qq45119626FangZhi/Temperature-Controlled-Blender/TempStir/MDK-ARM/Doc/使用文档.md

# TempStir 智能温控搅拌机 · 使用文档

> 适用固件：**v1.1**（Modbus 寄存器 `0x000F` = `0x0101`）
> 目标板：STM32F103RCT6 / STM32Cube HAL / FreeRTOS
> 工程：`MDK-ARM/TempStirV1.0.uvprojx`（Keil MDK V5.38 / ARMCC V5）
> 本文覆盖：**安装接线 → 上电 → 面板操作 → 控温/搅拌规则 → 通信 → 保护与故障码 → 烧录调试 → 出厂自检 → 老化测试 → 已知限制**

---

## 1. 产品概述

智能温控搅拌机：铝板加热 + 搅拌电机，双路 NTC 测温（液体 / 铝板），OLED 面板设定，支持 RS485/Modbus 与 BLE 蓝牙两路上位机，参数掉电保存，RTC 走时。

### 1.1 功能清单

| 功能 | 说明 | 状态 |
|---|---|---|
| 双路测温 | 液体 NTC（PB1）+ 铝板 NTC（PB0），Steinhart-Hart 换算 + 8 点滑动平均 + 断线/短路判定 | ✅ |
| 加热控温 | 液体目标温度 PID 闭环，PWM 20 kHz（TIM2_CH1 / PA0） | ✅ |
| 铝板限温 | 板温 ≥ 上限锁存断电，降到「上限 − 2.0℃」解除；`0` = 不限制 | ✅ |
| 搅拌调速 | 编码器测速 + 转速 PID 闭环，PWM 20 kHz（TIM4_CH3 / PB8） | ✅ |
| 堵转保护 | 占空比大但转速起不来，持续 3 s → 停机 + 故障位 bit5 | ✅ |
| 风扇自动 | 板温 ≥35℃ 开 / ≤32℃ 关，最短切换间隔 5 s | ✅ |
| 蜂鸣提示 | 短鸣 / 长鸣（4 kHz 无源，TIM1_CH1 / PA8） | ✅ |
| 面板 UI | 0.96" OLED 128×64 + 4 按键，6 行「设定/实测」 | ✅ |
| 定时 | 0~999 s，电机启动开始倒计时，归零自动停机 | ✅ |
| 参数存储 | M24C02 EEPROM，双槽 + CRC16 + 版本迁移（v4） | ✅ |
| RTC | DS3231 走时 + 1 Hz SQW 秒节拍，面板/串口校时 | ✅ |
| RS485 / Modbus RTU | UART4，9600 8N1，从机 1，32 个保持寄存器（03/06/10） | ✅ |
| BLE 蓝牙 | USART2 + ECB01C 透传，同一套 Modbus 帧 | ✅ |
| 故障监控 / 看门狗 | 故障字聚合、三源心跳、IWDG ≈1.6 s、上电打印复位原因 | ✅ |
| CAN | 本期未实现 | ⛔ |

---

## 2. 硬件接口

### 2.1 引脚与信号

| 功能 | 网络 | 引脚 | 说明 |
|---|---|---|---|
| 铝板 NTC | BOARD_ADC | PB0 / ADC1_IN8 | 10k 分压，室温 25℃ 原始值约 **2047** |
| 液体 NTC | LIQUID_ADC | PB1 / ADC1_IN9 | 同上 |
| 加热电流 | HEAT_I_ADC | PA4 / ADC1_IN4 | INA199 放大，R29 5 mΩ 采样 |
| 24 V 电压 | SUPPLY_24V_ADC | PC0 / ADC1_IN10 | 电源电压检测 |
| 加热 PWM | HEAT_PWM | PA0 / TIM2_CH1 | **20 kHz**，占空比 0~100% |
| 风扇 | MOTOR_ON | PA1 | **高有效** |
| 电机 PWM | MOTOR1 | PB8 / TIM4_CH3 | **20 kHz**；PB9（MOTOR2）**必须固定低**（拉高会反转/刹车） |
| 编码器 | M1_ENC_A/B | PB4 / PB5 / TIM3 | 正交编码器接口 |
| 蜂鸣器 | BUZZ | PA8 / TIM1_CH1 | 4 kHz 无源，50% 占空比驱动 |
| 按键 | KEY1~KEY4 | PC6 / PC7 / PC8 / PC9 | 内部上拉，按下接地（低有效） |
| OLED | — | PB6 / PB7（I2C1） | SSD1315，地址 0x3C 类 |
| EEPROM | — | PB10 / PB11（I2C2） | M24C02 |
| RTC | — | PB10 / PB11（I2C2） | DS3231；SQW → PC12（DS_INT） |
| 加热故障锁存 | HEAT_FAULT_N | PC3 | **低有效**（74LVC1G74 锁存），复位脚 FAULT_RST_N = PC2 |
| 调试串口 | — | PA9 / PA10（USART1） | **115200 8N1**，printf 重定向 |
| RS485 | — | PC10 / PC11（UART4） | MAX13487E 自动方向 |
| 蓝牙 | — | PA2 / PA3（USART2） | ECB01C，9600 8N1 |
| 调试口 | SWD | PA13 / PA14 | CMSIS-DAP |

### 2.2 上电顺序建议

1. 接好 24 V 加热电源与 MCU 电源（**加热组件禁止空载长时间通电**）；
2. 接好调试器（CMSIS-DAP）或 USB-串口（看日志）；
3. 上电 → OLED 显示 `TempStir V1.0`，串口打印启动信息（见 3.2）。

---

## 3. 上电与日志

### 3.1 上电默认状态

| 项 | 上电值 |
|---|---|
| 电机 | **停止**（必须人为启动） |
| 加热 | 关闭（需设定液体目标 + 启动电机） |
| 速度 / 液体目标 / 定时 | 从 EEPROM 恢复（默认 0 / 0 / 0） |
| 铝板上限 | 从 EEPROM 恢复（默认 **40℃**；旧固件的 1~34℃ 非法值会自愈为 40℃） |
| 通信 | RS485 + 蓝牙都开，9600 8N1，从机地址 1 |
| 蜂鸣器 | 静音 |

### 3.2 启动日志（USART1，115200）

```
[P7] reset cause: IWDG=0 WWDG=0 SW=0 POR=1 PIN=1 LPWR=0
[P7] fault monitor init
[P5] EEPROM=OK
[P5] DS3231=OK 2026-11-05 11:23:41 valid=1 sqw=1
[P5] PARAM speed=0 plate=40 liquid=0 time=0
[P5] CALIB mPID=2000/500/0 hPID=2000/50/0 PPR=44 gearX100=3000
[P5] STAT boot=85 run=2350 s heat=5211 s start=37
[P6] BLE baud=9600 (AT ok)
[P6] BLE name=BT_ECB1A6B01BA2 link=disconnected baud=9600
[P7] IWDG on (timeout ~1600 ms)
```

关键判读：

- `reset cause: IWDG=1` → 上次是**看门狗复位**（任务卡死/异常），不是正常上电；
- `EEPROM=NG` → 参数无法保存（检查 I2C2 / 芯片）；`DS3231=NG` → 时间不可用；
- `RTC time lost (OSF=1)` → 纽扣电池没电/未装，已用编译时刻兜底；
- `BLE ... link=disconnected` → 蓝牙在线但未连接手机，属正常。

---

## 4. 面板操作

### 4.1 按键

| 按键 | 短按 | 长按（≥600 ms） |
|---|---|---|
| **KEY1**（PC6） | 切换焦点：速度 → 铝板 → 液体 → 时间 → 循环 | 进入/退出 **RTC 校时页** |
| **KEY2**（PC7） | 当前项 **+1 步** | 600 ms 后每 80 ms 连发 |
| **KEY3**（PC8） | 当前项 **−1 步** | 600 ms 后每 80 ms **连发减值**（原「长按进六轴页」已停用，见 5.6） |
| **KEY4**（PC9） | **启动 / 停止电机**（启动即开始倒计时） | 进入 / 退出 **标定页**（见 4.5） |

> 焦点行前有 `>` 箭头。面板任意按键后 **8 s 内**通信写命令会被拒绝（返回异常码 06，防抢控）。
>
> **KEY4 为"松手生效"**：按下不动作，松开瞬间才执行启动/暂停（校时页=写入并退出、标定页=保存并退出）。长按 ≥600 ms 只切换页面，**不会改变电机启停状态**。KEY1/KEY2/KEY3 仍是"按下即触发"。

### 4.2 主界面（6 行，"设定/实测"）

```
TempStir V1.0
>Speed  100/80 rpm      设定转速 / 编码器实测转速（电机轴 RPM）
 Plate   60/25 C        铝板上限温度 / 铝板实测温度
 Liquid  45/23 C        液体目标温度 / 液体实测温度
 Time   60/45 s         设定时间 / 剩余时间（秒）
 Motor  Running         运行状态：Running / Idle
```

- 实测温度显示 `--` 表示 NTC 采样失败（断线/短路）；
- 无按键时每 480 ms 刷新一次；RTC 1 Hz 秒节拍到来时立即刷新。

### 4.3 参数范围

| 项 | 范围 | 步长 | 说明 |
|---|---|---|---|
| Speed | 0 ~ 500 rpm | 5 | 电机轴 RPM，与编码器同量纲 |
| Plate | 0 ~ 120 ℃ | 1 | **上限（保护门限）**；`0`=不限制；有效域 `{0} ∪ [35,120]`，1~34 会被当作 0 |
| Liquid | 0 ~ 100 ℃ | 1 | **加热目标**；`0` = 不加热 |
| Time | 0 ~ 999 s | 1 | `0` = 不限时 |

### 4.4 RTC 校时（长按 KEY1）

```
Set RTC
Date 2026-11-05
Time 11:23:41
K1  next field
K2+ K3-  K4 save
Motor  Idle
```

- KEY1 循环切换 **年 / 月 / 日 / 时 / 分 / 秒**；
- KEY2/KEY3 增减（年 2000~2099、月 1~12、日按当月天数、时分秒 24/60 循环）；
- KEY4 **松开时**写入 RTC 并退出；星期自动推算。

### 4.5 标定页（长按 KEY4 进入，KEY4 保存并退出）

出厂/维修标定用，**只改标定参数，不动速度与温度目标，也不改变电机/加热状态**。

```
CALIB 3/8
NTC R25 ohm
10000 ohm
K1 next  K2+ K3-
K4 save+exit
Motor  Idle
```

| 序号 | 项目 | 含义 | 范围 / 步长 |
|---|---|---|---|
| 1 | Encoder PPR | 编码器每转计数（线数×4） | 4~4096，步 4 |
| 2 | Gear x100 | 减速比×100（例 `3000` = 30.00） | 100~10000，步 100 |
| 3 | NTC R25 ohm | NTC 25℃ 阻值 | 1000~100000Ω，步 500 |
| 4 | NTC B (K) | NTC B 常量 | 1000~6000K，步 50 |
| 5 | NTC Rup ohm | 分压上拉电阻 | 500~100000Ω，步 500 |
| 6 | Heat OC raw | 加热过流判定阈值（ADC 原始值） | 500~4000，步 50 |
| 7 | Liquid off | 液体温度校准偏移 | −100~100（0.1℃），步 1 |
| 8 | Board off | 铝板温度校准偏移 | −100~100（0.1℃），步 1 |

- KEY1 切换项目（循环），KEY2/KEY3 增减（长按连发），**KEY4 短按松开即保存并退出**（写 EEPROM + 立即生效，无需重启）；
- 长按 KEY4（≥600 ms）只进出标定页，**不保存**；按住期间不会误改电机启停；
- 标定时建议电机停止，改完 NTC 参数后观察主界面实测温度与实际温度是否一致，再用偏移微调；
- 保存时串口打印 `[P8] CALIB saved: ppr=… gearX100=… R25=… B=… Rup=… OC=… offL=… offB=…`。

---

## 5. 控制逻辑与安全行为

### 5.1 温度语义（**重要**）

| 项 | 含义 |
|---|---|
| 面板 **Liquid** | **加热目标温度**（唯一 PID 设定值）。=0 时不加热。 |
| 面板 **Plate** | **铝板上限温度 + 铝板实测值**。上限只做保护，**不是加热目标**。 |

> 想加热：设 `Liquid`（如 30~45℃），并**启动电机**；`Plate` 保持 40℃ 作为板温上限即可。

### 5.2 加热启动条件（全部满足才加热）

1. 无加热类故障（HEAT_FAULT_N / 过流 / NTC 异常 / 铝板限温锁存）；
2. **电机运行中**（目标转速 ≠ 0 且未堵转）；
3. 液体目标温度 > 0；
4. 液体温度低于目标（或 PID 输出 > 0）。

### 5.3 加热停止条件

| 触发 | 行为 | 恢复 |
|---|---|---|
| 液体到目标（曾低于目标后首次达到） | 关加热**锁存** + 蜂鸣长鸣 1 s + 状态字 bit9 | 改液体目标 / 重新启停电机 / `0x0007` 清故障 |
| 铝板 ≥ 上限 | 关加热锁存 + 故障位 bit4 | 板温降到「上限 − 2℃」以下，或改上限，或清故障 |
| 板温 NTC 无效 | 立即关加热（fail-safe）+ 故障位 bit3 | NTC 恢复正常见后自动恢复 |
| 电机停机 / 堵转 | 撤销加热许可 | 重新启动电机 |
| 加热硬件故障 / 过流 | 立即关加热 + 故障位 bit0/bit1 | 排除硬件后清故障（`0x0007` bit2） |

### 5.4 其它自动行为

- **风扇**：板温 ≥35.0℃ 开、≤32.0℃ 关，两次切换至少间隔 5 s；
- **液温上穿 30.0℃**：蜂鸣长鸣 1 s（边沿触发，**下降不响**；默认不停电机，宏 `APP_TEMP_MARK_STOP_MOTOR` 可改为同时停机）；
- **定时**：KEY4 启动即开始倒计时，归零自动停机并落盘统计；
- **统计**：累计运行时间 / 加热时间 / 启动次数，每 5 分钟或停机时写 EEPROM。

### 5.5 保护一览

| 保护 | 阈值 / 判据 | 动作 |
|---|---|---|
| 加热硬件故障 | HEAT_FAULT_N 低 | 关加热，故障位 bit0 |
| 加热过流 | 电流 ADC raw > 3500（**待整定**） | 关加热，故障位 bit1 |
| 液体 / 铝板 NTC 断线短路 | raw < 100 或 > 4000 | 关加热（液体 NTC 异常也禁止加热） |
| 铝板限温 | 板温 ≥ 上限（回差 2.0℃） | 关加热锁存，故障位 bit4 |
| 电机堵转 | 目标>0 且占空比≥40% 且 RPM<目标×25% 且 <10，连续 3 s | 停机锁存，故障位 bit5 |
| 任务卡死 | 任一关键任务心跳丢失 >500 ms | WDG 停喂，IWDG 约 1.6 s 复位 |
| EEPROM / RTC 异常 | 探测失败 / OSF=1 | 故障位 bit6 / bit7（不禁止加热/电机） |
| 倾斜保护（P9） | max(\|roll\|,\|pitch\|) > 门限（默认 10.0°，0x0036）持续 500 ms，回差 3.0° 且持续 500 ms 解除 | 电机运转中立即停机 + 蜂鸣器长鸣；状态位 0x002A bit8 = 倾斜锁存 |
| 打滑告警（P9/M4） | 陀螺推算转速与编码器偏差 > 门限（默认 15.0%，0x0034）持续 1 s | **当前默认关闭**（IMU 固定底座，见 5.6）；仅在 `APP_IMU_SLIP_ENABLE=1` 时生效：仅告警不停机 |
| 升温异常（A3） | 目标液温>0、占空比 ≥50%、电机运行中，120 s 内液温上升 <2.0℃ | **仅告警**：状态字 bit12 + 蜂鸣 1.5 s + 串口 `[P11] liquid no-rise`（不停机、不关加热） |
| 板温不升（P10，默认关） | 板温目标模式下占空比 ≥50% 且板温 raw 30 s 不动 | 关加热锁存（该模式默认关闭） |
| 堵转辅助（M5，默认关） | 0x003B bit0=1 且 IMU 检测到振动（振动 RMS > 0x0035） | 堵转判定时间 3 s → 1 s |

### 5.6 六轴（LSM6DSM）相关行为

- 采集：SPI2 100 Hz（CS=PB12），上电 2 s 自动零偏标定并落盘；未贴件/通信失败时所有判据自动降级，**电机/加热/通信不受影响**（故障位 bit8 提示）；
- 倾斜保护：见 5.5。倾角超限会**停机**，因此“倾斜锁存期间 App/面板再按启动会被再次停掉”属预期行为；
- 打滑（M4）：**默认关闭**。本机 IMU 固定在底座、不随搅拌轴转动，陀螺测不到转速（ω_imu 恒 0），偏差恒为 100.0%，会误报 bit7/状态字 bit11，故 `APP_IMU_SLIP_ENABLE=0`；判据代码保留，将来若 IMU 改为随轴装配再置 1。关闭后 `0x002F` 恒 0；
- 参数（打滑/振动/倾斜/斜率/过流）可现场改：面板标定页覆盖 PPR/减速比/NTC/过流/温度偏移，**六轴门限用 App「六轴门限 / 参数设置」或网页版参数区**（写 0x0033~0x0036、0x003A），即时生效并掉电保存；
- **面板六轴显示页（原第 7 页，长按 KEY3 进出）已停用**：该页占用 KEY3 长按，导致长按无法连发减值，故 `menu_ui.c` 的 `MENU_UI_IMU_PAGE_ENABLE=0`，入口不调用、KEY3 长按归还连发；页面代码完整保留，改宏为 `1` 重烧即恢复（届时 KEY3 长按会被页面占用）。六轴数据仍可通过 0x0020~0x0032 读取（App/网页版）；
- 可选扩展（默认全关，需改宏重烧并实机复验）：`APP_IMU_SELFTEST_ENABLE`（上电 CTRL5_C 自检）、`APP_IMU_FIFO_ENABLE`（FIFO 批量采样）、`APP_MOTOR_STALL_ASSIST_DEFAULT`（运行期默认开辅助堵转）。

---

## 6. 通信

### 6.1 RS485 / Modbus RTU（**当前版本不支持**）

> ⚠️ **本版本不使用 RS485 通道**：主站实测所需的 USB-485 转换器未到位，且该通道不在本版出厂功能范围内。
> 代码保留（UART4 + MAX13487E），但**不要按 RS485 交付**；下表的寄存器/帧格式仍然有效，**通过蓝牙访问**。

- 参数（蓝牙链路）：**9600 8N1，从机地址 1**；
- 功能码：`03` 读保持寄存器、`06` 写单个、`10` 写多个；
- 异常码：`02` 非法地址、`04` 数值非法/保护联锁、`06` 从机忙（面板 8 s 占用）。

### 6.2 保持寄存器表（**64 个，0x0000~0x003F**；v1.2 起扩表，旧上位机只读前 32 个不受影响）

| 地址 | 名称 | 类型/单位 | 读写 | 说明 |
|---|---|---|---|---|
| 0x0000 | 当前液温 | int16 / 0.1℃ | R | |
| 0x0001 | 目标液温 | int16 / 0.1℃ | R/W | 0~1000（0~100.0℃），即加热目标 |
| 0x0002 | 当前转速 | int16 / rpm | R | 编码器实测（电机轴） |
| 0x0003 | 目标转速 | int16 / rpm | R/W | 0~500 |
| 0x0004 | 剩余时间 | uint16 / s | R | |
| 0x0005 | 系统状态字 | 位域 | R | 见 6.4 |
| 0x0006 | 故障码 | 位域 | R | 见 6.5 |
| 0x0007 | 控制命令 | 位域 | R/W | 见 6.6（写入后自动执行） |
| 0x0008 | 铝板温度 | int16 / 0.1℃ | R | 实测 |
| 0x0009 | 加热占空比 | uint16 / % | R | |
| 0x000A | 电机占空比 | uint16 / % | R | |
| 0x000B | 设定时间 | uint16 / s | R/W | 0~999 |
| 0x000C | 风扇状态 | 0/1 | R | |
| 0x000D/0x000E | 设备 ID | 32 位 | R | 由 UID 派生 |
| 0x000F | 固件版本 | 高字节主/低字节次 | R | v1.1 = 0x0101 |
| 0x0010 | 从机地址 | 1~247 | R/W | 重启生效（本版 RS485 不对外支持） |
| 0x0011 | 波特率代码 | 0~4 | R/W | 0=9600 1=19200 2=38400 3=57600 4=115200，重启生效 |
| 0x0012/0x0013 | 累计运行时间 | 32 位 / s | R | |
| 0x0014 | 面板焦点项 | 0~3 | R/W | 0=速度 1=铝板 2=液温 3=时间（OLED 箭头随动） |
| 0x0015 | 铝板上限温度 | 整数 ℃ | R/W | `0` 或 `35~120`；写 1~34 返回异常码 04 |
| 0x0018~0x001D | PID 参数镜像 | ×1000 定点 | R | 只读预留 |

#### 6.2.1 六轴 / 姿态 / 斜坡 / 打滑区块（0x0020~0x0039，v1.2 起）

| 地址 | 名称 | 类型/单位 | 读写 | 说明 |
|---|---|---|---|---|
| 0x0020~0x0022 | 加速度 X/Y/Z | int16 / mg | R | 静止时 Z ≈ +1000 |
| 0x0023~0x0025 | 角速度 X/Y/Z | int16 / 0.1dps | R | 已扣上电零偏 |
| 0x0026/0x0027 | 横滚 / 俯仰 | int16 / 0.1° | R | 加速度解算 |
| 0x0028 | 相对偏航 | int16 / 0.1° | R | 陀螺积分，会漂移 |
| 0x0029 | 片内温度 | int16 / 0.1℃ | R | |
| 0x002A | IMU 状态位 | 位域 | R | 0x0001 有效 / 0x0002 静止 / 0x0004 转动 / 0x0008 振动 / 0x0010 倾斜 / 0x0040 已标定 / 0x0080 打滑 / 0x0100 倾斜锁存 |
| 0x002B | 振动 RMS | uint16 / mg | R | 1 s 窗 |
| 0x002C | 角加速度 | int16 / 0.1dps/s | R | 旋转轴，低通后 |
| 0x002D | 斜坡状态 | 0~3 | R | 0 停 / 1 加速 / 2 匀速 / 3 减速 |
| 0x002E | 斜坡指令转速 | int16 / rpm | R | PID 跟随的中间量 |
| 0x002F | 打滑偏差 | int16 / 0.1% | R | 陀螺推算转速与编码器偏差 |
| 0x0030 | IMU 控制字 | 位域 | R/W | bit1 零偏标定 / bit2 保存参数 / bit3 清事件（写后读回恒 0） |
| 0x0031/0x0032 | 加速度 / 陀螺配置 | 低字节量程 高字节 ODR | R/W | 重启生效（0~3 / 0~9） |
| 0x0033 | 加减速斜率 | uint16 / rpm/s | R/W | 默认 600 |
| 0x0034 | 打滑门限 | uint16 / 0.1% | R/W | 默认 150 = 15.0%；**打滑判据当前默认关闭**（IMU 固定底座），地址与门限保留 |
| 0x0035 | 振动门限 | uint16 / mg | R/W | 默认 300 |
| 0x0036 | 倾斜门限 | uint16 / 0.1° | R/W | 默认 100 = 10.0° |
| 0x0037/0x0038 | 加速 / 减速耗时 | uint16 / ms | R | 上次实测（口径=目标变更→到达，含首拍；600 rpm/s 爬 200 rpm ≈ 400 ms） |
| 0x0039 | 峰值角加速度 | int16 / 0.1dps/s | R | 本次启动以来 |

#### 6.2.2 v1.3 新增：现场可调参数与实测统计（0x003A~0x003C）

| 地址 | 名称 | 类型/单位 | 读写 | 说明 |
|---|---|---|---|---|
| 0x003A | 加热过流阈值 | uint16 / ADC raw | R/W | 合法 100~4095，掉电保存；与面板标定页同一份数据 |
| 0x003B | 堵转辅助位域 | 位域 | R/W | bit0 = 1 启用振动辅助堵转（3 s→1 s），默认 0（掉电保存） |
| 0x003C | 实测统计控制 | 位域 | R/W | bit0 周期打印 `[TUNE]`（每 5 s）/ bit1 立即打印一行 / bit2 清统计；**不落盘**，复位后为 0 |
| 0x003D~0x003F | 保留 | — | R | 读 0 |

> 现场整定流程（A2）：写 `0x003C = 0x0003`（开打印 + 立即打一行）→ 串口每 5 s 出现一行 `[TUNE]`，含
> `slip=实测/门限`、`vib=实测/门限`、`acc/dec ms`、`gyroZ/biasZ`（零偏温漂）、`novRise`、`assist`，
> 据此改 0x0033~0x0036 / 0x003A 后即时生效并保存；整定完写 `0x003C = 0` 恢复静默。

### 6.3 读写示例（从机 1）

- 读 0x0000~0x0006（7 个寄存器）：
  `01 03 00 00 00 07 CRC_L CRC_H`
- 写目标液温 = 35.0℃（0x015E = 350）：
  `01 06 00 01 01 5E CRC_L CRC_H`
- 启动电机：`01 06 00 07 00 01 +CRC`；停止：`… 00 02 …`；清故障：`… 00 04 …`

### 6.4 系统状态字（0x0005）

| 位 | 掩码 | 含义 |
|---|---|---|
| bit0 | 0x0001 | 电机运行中 |
| bit1 | 0x0002 | 加热输出中 |
| bit2 | 0x0004 | 风扇运行中 |
| bit3 | 0x0008 | 故障态（故障字 ≠ 0） |
| bit4 | 0x0010 | 定时计时中 |
| bit5 | 0x0020 | RTC 有效 |
| bit6 | 0x0040 | 面板刚被操作（8 s 内） |
| bit8 | 0x0100 | 蓝牙已连接 |
| bit9 | 0x0200 | 液温已达目标，加热结束（锁存） |
| bit10 | 0x0400 | P9：六轴数据有效 |
| bit11 | 0x0800 | P9：打滑告警（陀螺×编码器偏差） |
| bit12 | 0x1000 | **A3：液体升温异常告警**（仅告警，不属于故障字，不停机也不关加热） |

### 6.5 故障码（0x0006）

| 位 | 掩码 | 含义 | 处置 |
|---|---|---|---|
| bit0 | 0x0001 | 加热硬件故障锁存 | 查 HEAT_FAULT_N 回路，排除后清故障 |
| bit1 | 0x0002 | 加热过流 | 查加热组件/短路，阈值待整定 |
| bit2 | 0x0004 | 液体 NTC 异常 | 查接插件/线束 |
| bit3 | 0x0008 | 铝板 NTC 异常 | 查接插件/线束（此位会禁止加热） |
| bit4 | 0x0010 | 铝板限温触发 | 降温或改上限 |
| bit5 | 0x0020 | 电机堵转 | 排除机械卡阻后 KEY4 停机重启或清故障 |
| bit6 | 0x0040 | EEPROM 异常 | 查 I2C2 / M24C02 |
| bit7 | 0x0080 | RTC 掉电丢时 | 换纽扣电池并重新校时 |
| bit8 | 0x0100 | P9：IMU 通信/自检异常 | 查 SPI2（PB12~PB15）/ 是否贴件；不影响其它功能 |

> 注意：液体升温异常（A3）**不进故障字**，只体现在状态字 bit12，避免被“加热类故障”掩码连带触发紧急关加热。

### 6.6 控制命令（0x0007）

| 位 | 掩码 | 动作 |
|---|---|---|
| bit0 | 0x0001 | 启动电机（堵转故障未清时返回 04） |
| bit1 | 0x0002 | 停止电机 |
| bit2 | 0x0004 | 清故障（硬件故障锁存 + 铝板限温锁存 + 堵转锁存） |
| bit3 | 0x0008 | 立即保存参数到 EEPROM |
| bit4 | 0x0010 | 恢复默认参数 |

### 6.7 BLE 蓝牙

- 模块：ECB01CV2-SOP8，出厂名 **`BT_ECB1A6B01BA2`**（名字由 MAC 派生，**不支持自定义名**）；
- 连接方式：**必须用 BLE 工具（如 nRF Connect）连 GATT**，手机系统"配对"会提示失败，属正常；
- 服务 / 特征：`FFF0`（服务）、`FFF1`（Notify，**需在手机侧手动订阅**）、`FFF2`（Write）；
- MTU 未协商（=23）时单包 ≤20 字节，**一次读 ≤7 个寄存器**；MTU 247 可整表读；
- 帧格式与 RS485 完全相同（Modbus RTU + CRC16，主站侧需自行组帧）。

### 6.8 上位机

| 上位机 | 位置 / 方式 |
|---|---|
| 安卓 App「TempStir 蓝牙控制台」 | BLE GATT 直连，功能等同面板 |
| 网页版 | `Doc/web/tempstir_rs485.html`，Chrome/Edge 的 **Web Serial** → USB-485 → 板载 485A/485B。1 s 轮询 0x0000~0x0015，**并追加读 0x0020~0x003F**（六轴/参数区，旧固件自动停读），参数区可写入打滑/振动/倾斜/斜率/过流并开关「辅助堵转 / 统计打印」。**⛔ 本版不支持 RS485，此上位机暂不可用**（文件保留备查） |

> 注意：CherryUSB CMSIS-DAP 的虚拟串口（COM5）**不是** 485 通道，网页版必须选 USB-485 转换器的串口。

---

## 7. 参数存储与 RTC

- **EEPROM（M24C02，v5）**：UI 参数、PID 增益（×1000）、校准系数（PPR/减速比/温度偏移）、**NTC 曲线参数（R25/B/上拉）与加热过流阈值**、通信参数、运行统计；双槽 + CRC16 + 版本迁移（v4 及更早数据上电自动迁移，新字段补默认值）；
- 写入策略：参数改动**静置 2 s** 落盘（防按键连发磨损），统计每 5 分钟或停机落盘；
- **v4 → v5 迁移已实测通过**：升级后启动日志出现 `[P8] NTC R25=10000 B=3950 Rup=10000 | heatOC=3500 | offL=0 offB=0`，且 `[P5] STAT boot=` 连续递增（85 → 90），说明旧参数与统计被沿用、未退回默认值；
- **RTC（DS3231）**：OSF=1 时用编译时刻兜底并打印提示；1 Hz SQW 经 PC12 通知 UI 刷新。

---

## 8. 烧录与调试

```powershell
# 编译
Start-Process "D:\Program Files\Keil_MDK\UV4\UV4.exe" -ArgumentList '-b','TempStirV1.0.uvprojx' -Wait
# 全量重建
Start-Process "D:\Program Files\Keil_MDK\UV4\UV4.exe" -ArgumentList '-r','TempStirV1.0.uvprojx' -Wait
# 烧录（CMSIS-DAP）
Start-Process "D:\Program Files\Keil_MDK\UV4\UV4.exe" -ArgumentList '-f','TempStirV1.0.uvprojx' -Wait
```

- 调试器：CMSIS-DAP（CherryUSB），Flash 算法 `STM32F10x_512.FLM`；
- 若首次烧录报 `Target DLL has been cancelled`，**再执行一次即可**（探针会话偶发未建立）；
- 单步调试时 IWDG 已用 `DBGMCU_CR` 冻结，不会被看门狗打断；
- 当前构建：`Code=63088 RO=2412 RW=712 ZI=20624`，`0 Error(s), 0 Warning(s)`。

---

## 9. 出厂自检 / 整机联调清单

> 每台整机出厂前按下表逐项执行，全部 ✅ 才算通过。`[软件已核对]` 表示代码与构建层面已验证，仍需实机复核。

| # | 项目 | 操作 | 预期 | 状态 |
|---|---|---|---|---|
| 1 | 上电启动 | 上电 | OLED 显示 `TempStir V1.0`；串口打印 `[P7] reset cause` / `[P5] EEPROM=OK` / `DS3231=OK` | [软件已核对] |
| 2 | 显示刷新 | 静置观察 | 每 ~0.5 s 刷新，"实测"温度随环境变化 | [软件已核对] |
| 3 | 按键消抖 | 逐个短按 KEY1~KEY4 | 无连跳/漏按；`>` 箭头循环移动；KEY4 在**松手**时启停 | [软件已核对] |
| 4 | 参数增减 | 焦点在 Speed/Plate/Liquid/Time 时按 KEY2/KEY3 | 按步长增减，长按连发（KEY3 长按=连发减值，不再切六轴页），范围受限 | [软件已核对] |
| 5 | 铝板上限自愈 | 把 Plate 调到 30 | 自动变为 0（不限制）或 40，不锁死加热 | [软件已核对] |
| 6 | RTC 校时 | 长按 KEY1 → 改日期时间 → KEY4 | 校时成功并退出；重上电时间继续走 | ✅ 已实测 |
| 7 | 电机启动 | 设 Speed=100 → KEY4 | 电机转，`Motor Running`，实测 RPM 上升并稳定在 ±5% | ✅ 已实测 |
| 8 | 软启动/停机 | KEY4 停止 | 占空比按 5%/周期下降，无冲击 | ✅ 已实测 |
| 9 | 定时停机 | 设 Time=10 → KEY4 | 剩余时间倒数，归零自动停机 | ✅ 已实测 |
| 10 | 加热启动 | 设 Liquid=35、Plate=40 → KEY4 | 加热占空比 >0，液体温度上升 | ✅ 已实测 |
| 11 | 到温完成 | 液温升到目标 | 关加热、长鸣 1 s、状态字 bit9 | ✅ 已实测 |
| 12 | 铝板限温 | 把 Plate 设为略高于当前板温 | 板温到上限后加热断电，故障位 bit4 | ✅ 已实测 |
| 13 | 30℃ 提示音 | 液温由 <30 升到 ≥30 | 长鸣 1 s；降到 30 以下不再响 | ✅ 已实测 |
| 14 | 风扇 | 板温 ≥35℃ | 风扇开；≤32℃ 关；两次切换 ≥5 s | ✅ 已实测 |
| 15 | 液体 NTC 断线 | 拔液体 NTC | 显示 `--`，故障位 bit2，加热断开 | ✅ 已实测 |
| 16 | 铝板 NTC 断线 | 拔铝板 NTC | 显示 `--`，故障位 bit3，加热断开 | ✅ 已实测 |
| 17 | 加热硬件故障 | 拉低 HEAT_FAULT_N | 加热断电、故障位 bit0；启动被拒（04） | ✅ 已实测 |
| 18 | 电机堵转 | 运行中抱死电机轴 | ≈3 s 后停机，故障位 bit5；启动被拒（04） | ✅ 已实测 |
| 19 | IWDG 复位 | 任务卡死（心跳丢失） | 日志 `WDG: … heartbeat lost … stop feeding`，≈1.6 s 复位，复位原因 `IWDG=1` | ✅ 已实测 |
| 20 | EEPROM 掉电 | 改参数后断电 3 s 再上电 | 参数保持一致；`[P5] STAT boot=` 递增 | ✅ 已实测 |
| 21 | 恢复默认 | 写 `0x0007`=0x0010 | 参数回默认（Speed 0 / Plate 40 / Liquid 0 / Time 0） | ✅ 已实测 |
| 22 | Modbus 读 | 主站 `03` 读 0x0000~0x0015 | 数据合理、CRC 正确 | ⛔ 本版不支持 RS485 |
| 23 | Modbus 写 | `06` 写 0x0001=350 | 目标液温变 35.0℃，OLED 同步 | ⛔ 本版不支持 RS485 |
| 24 | 异常码 | 写 0x0001=2000 / 写只读寄存器 / 面板占用时写 | 分别返回 04 / 02 / 06 | ⛔ 本版不支持 RS485（蓝牙侧已验 04/06） |
| 25 | 蓝牙连接 | nRF Connect 连 `BT_ECB1A6B01BA2`，订阅 FFF1 | 能收到数据；状态字 bit8=1 | ✅ 已验收（P6） |
| 26 | 面板仲裁 | 按键后 8 s 内用 App 写参数 | 返回 06 忙，8 s 后可写 | ✅ 已验收（P6） |
| 27 | 温控稳态 | Liquid=45 运行 30 min | 液温稳定在 45±2℃，无持续振荡 | 待实测（老化项） |
| 28 | 标定页 | 长按 KEY4 → 改 PPR/减速比/NTC R25·B·上拉/过流阈值/温度偏移 → KEY4 保存 | 打印 `[P8] CALIB saved …`，改值即时生效，重启后仍保持（v5 迁移） | ✅ 已实测 |

---

## 10. 老化测试建议

| 项 | 建议 |
|---|---|
| 配置 | Speed=200 rpm，Liquid=45℃，Plate=60℃，Time=0（不限时） |
| 时长 | ≥ 24 h（首次样机建议 72 h） |
| 记录 | 每小时记录一次：液温、板温、转速、加热/电机占空比、故障字 |
| 判据 | ① 无 `[P7] reset cause: IWDG=1`（无看门狗复位）；② 故障字恒 0；③ 液温 45±2℃、转速目标 ±5%；④ 无明显异常噪声/异味；⑤ 结束后 `[P5] STAT` 统计递增合理；⑥ 状态字 bit12 不置位（无升温异常告警） |
| 风险点 | 加热 PWM 20 kHz 下 AO4184A 开关损耗需复核 Q4/U20 温升；铝板限温 40~60℃ 时应能稳定断电/恢复 |

**A1 老化/稳态记录执行办法（需实机，脚本代替不了）**

1. 上电后确认启动日志：`[P7] reset cause: …`、`[P9] … -> OK`、`[P5] PARAM/CALIB/STAT`；
2. 上位机（App 或网页版）写 `0x003C = 0x0003` 打开实测统计 → 串口每 5 s 一行 `[TUNE]`；
3. 每小时从 `[TUNE]` 抄一行到下表（或整段保存串口日志，事后筛选 `[TUNE]` / `[P7]` / `[P11]`）；
4. 24 h 后核对判据，并停电机、写 `0x003C = 0` 关闭打印，最后读 `0x0006`（故障字）与 `0x0012/0x0013`（累计运行）。

| 时刻 | liq(℃) | plate(℃) | rpm 实测/目标 | heat% | 故障字 | novRise | 备注 |
|---|---|---|---|---|---|---|---|
| 0 h | | | | | | | |
| 1 h | | | | | | | |
| … | | | | | | | |
| 24 h | | | | | | | |

---

## 11. 已知限制与待标定项

| 项 | 现状 | 影响 |
|---|---|---|
| NTC 参数 | 默认 `R25=10kΩ`、`B=3950`、上拉 10k；**已可现场标定**（标定页 3~5 项，存 EEPROM v5） | 出厂默认仍为通用值，建议每批按实测 NTC 标定一次 |
| 编码器 PPR / 减速比 | 默认 `44` / `30.00`；**已可现场标定**（标定页 1~2 项） | 不标定则显示转速与实际有比例偏差 |
| 加热过流阈值 | 默认 `3500` raw；**已可现场标定**（标定页第 6 项） | 需按实际加热电流整定，避免误保护/miss 保护 |
| 温度偏移 | 液温/板温各 ±10.0℃ 可调（标定页 7~8 项） | 用于补偿个体差异与 NTC 拟合残差 |
| 铝板 NTC 热耦合 | 需确认 NTC 是否紧贴铝板 | 若脱开，板温不随加热变化，限温失效（已有"板温不升"失控保护，仅板温目标模式启用） |
| 液体加热"升温异常" | **已实现（A3，v1.3）**：120 s 内升温 <2.0℃ → 仅告警（状态字 bit12 + 蜂鸣 + 日志），默认开启，`APP_HEAT_NORISE_ENABLE=0` 可关 | 告警不做保护动作；需要停机/关加热时改宏 |
| RS485 / Modbus 主站 | **本版不支持**（代码保留，不对外交付） | 上位机请用蓝牙 App |
| 六轴门限整定 | 打滑 A3 / 斜坡 A4 / 零偏温漂 A5 / 振动 A6 **仍待实机整定**；现场可写 0x0033~0x0036 即时生效，或用 `[TUNE]` 统计行观察 | 门限为经验值，整定前打滑/振动判据可能偏灵敏或偏迟钝 |
| IMU 安装位置 | **固定在底座、不随轴转动**（2026-11-06 现场确认） | 陀螺测不到转速 → 打滑判据默认关闭；振动 RMS 只能反映底座振动（实测转动/静止均 ~18 mg），不能代表转子振动 |
| 转速稳态 | 200 rpm 目标下实测 190~211 rpm，占空比 42~59% 小幅摆动 | 压 ±5% 验收边界；如需收紧要调 PID（Kp 2.0→1.5）或重标 PPR/减速比，属 P3 调参范围 |
| 六轴可选扩展 | G1 自检 / G7 FIFO **默认关闭**（`APP_IMU_SELFTEST_ENABLE` / `APP_IMU_FIFO_ENABLE`），代码已就绪但未实机验证 | 需要时置 1 重烧并复验；G7 的时间类判据仍按 10 ms 估算 |
| 面板六轴页 | **已停用**（`MENU_UI_IMU_PAGE_ENABLE=0`，KEY3 长按归还连发减值，见 5.6） | 面板上不再能看六轴原始值，改用 App/网页版读 0x0020~0x0032 |
| 堵转辅助 M5 | 已可运行期开启（0x003B bit0），**默认关**；判定门限未实机整定 | 打开前先确认振动 RMS 与门限的余量（看 `[TUNE]`） |
| CAN | 未实现 | — |
| 铝板上限作目标 | P10 模块保留但**默认关闭** | 加热目标只认 Liquid，符合本版语义 |

---

## 12. 常见问题（FAQ）

**Q1：启动电机后不加热？**
A：① `Liquid` 是否为 0（0 = 不加热）；② 故障字是否为 0（bit2/3/4 会禁止加热）；③ 板温是否已达 `Plate` 上限。

**Q2：加热到目标就停了，之后不再加热？**
A：这是"到温完成"锁存（正常）。改一下 `Liquid` 目标、重新启停电机，或写 `0x0007` 清故障即可重新加热。

**Q3：OLED 上温度显示 `--`？**
A：该路 NTC 采样失败（断线/短路）。故障位 bit2/bit3 会置位，加热会被禁止。

**Q4：手机蓝牙"配对失败"？**
A：该模块是 BLE 透传，不走经典配对。请用 nRF Connect 等工具连 GATT（FFF0/FFF1/FFF2），并手动订阅 FFF1。

**Q5：蓝牙读回来是乱码/无响应？**
A：① 是否订阅了 FFF1；② MTU 23 时一次读 ≤7 个寄存器；③ 帧必须带 CRC16。

**Q6：面板改了参数，App 写不进去？**
A：面板操作后 8 s 内通信写会被拒绝（异常码 06），属仲裁设计。

**Q7：板子上电后约 12 s 自动重启？**
A：仅存在于已删除的 IWDG 自检版本（`APP_IWDG_TEST_ONESHOT=1`）。当前固件无此行为；若仍出现，检查 `reset cause` 是否为 `IWDG=1`（真故障）或 `POR=1`（电源不稳）。

**Q8：烧录报 `Target DLL has been cancelled`？**
A：探针会话未建立，通常重试一次即可；仍失败检查 CMSIS-DAP 连接与目标供电。

**Q9：实测温度与实际差几度，怎么校准？**
A：长按 KEY4 进标定页 → 先按 NTC 实际规格改 `R25`/`B`/`Rup`（第 3~5 项）→ 保存；若仍有固定偏差，再用第 7/8 项温度偏移微调（单位 0.1℃）。改完即时生效。

**Q10：转速显示不准？**
A：标定页第 1 项 `Encoder PPR`（线数×4）与第 2 项 `Gear x100`（减速比×100）。可先设一个已知转速，按"显示值/实际值"比例修正 PPR。

**Q11：能用 RS485 接电脑吗？**
A：**本版不支持**。请用手机 BLE（`BT_ECB1A6B01BA2`，FFF0/FFF1/FFF2）。

---

## 13. 版本记录

| 日期 | 版本 | 内容 |
|---|---|---|
| 2026-11-03 | v1.0 | P0~P3：框架、BSP、传感器/执行器、转速与温控 PID |
| 2026-11-04 | v1.0 | P4~P5：OLED 菜单、EEPROM 参数、RTC 校时；加热 PWM 改 20 kHz 消除低鸣；风扇/板温回差 |
| 2026-11-05 | v1.1 | P6：Modbus/蓝牙通信与上位机；P7：故障监控、IWDG、铝板上限 40℃、到温完成、堵转检测；温度语义定稿（Liquid=目标 / Plate=上限+实测）；移除调试日志 |
| 2026-11-05 | v1.1 | P8：整机联调清单与老化方案；**硬件自检 18 项已实测通过**（电机启停/软启动/定时停机、加热启动与到温完成、铝板限温、30℃ 提示音、风扇滞回、双路 NTC 断线、HEAT_FAULT_N 注入、堵转 bit5、EEPROM 掉电保持、恢复默认、IWDG 复位）；**新增标定页**（长按 KEY4）与 EEPROM v5：NTC R25/B/上拉、加热过流阈值、PPR、减速比、温度偏移可现场标定；文档《使用文档.md》 |
| 2026-11-06 | v1.2 | P9：LSM6DSM 六轴接入（姿态/振动/打滑/倾斜保护/速度斜坡），寄存器表扩到 64 个（0x0020~0x0039），固件版本字 0x0102 |
| 2026-11-06 | v1.3 | A2~A8：① A3 液体升温异常判定（仅告警，状态字 bit12 + 蜂鸣 + 日志）；② A4 现场可调补齐 0x003A 加热过流阈值 / 0x003B 堵转辅助；③ A2 新增 `app_tune` 模块与 0x003C 实测统计控制（`[TUNE]` 行）；④ A8 六轴 G1 自检 / G7 FIFO / M5 运行期开关（全部默认关闭）；⑤ A5 安卓 App 新增「六轴门限 / 参数设置」弹窗；⑥ A6 网页版补齐 0x0020~0x003F 读取与参数写入；固件版本字 0x0103 |
| 2026-11-06 | v1.4 | 面板按键两项修复：① **KEY4 改为"松手生效"**——原在按下稳定 120 ms 即触发，导致长按 KEY4 会先启动电机再进标定页；现按下只置 armed，松开才动作，长按 ≥600 ms 仅进出标定页、不改变电机状态（CODE 73644）；② **停用面板六轴显示页**（原长按 KEY3 进第 7 页），因其占用 KEY3 长按导致连发减值失效；`MENU_UI_IMU_PAGE_ENABLE=0`，页面代码保留、入口不调用，KEY3 长按恢复每 80 ms 连发减值（CODE 72904，比上版少 740 字节） |
| 2026-11-06 | v1.5 | 仅内部结构重构，**功能与操作方式零变化**：新增 `User/Dri` 器件驱动层（`dri_ble` / `dri_buzzer` / `dri_fan` / `dri_m24c02` / `dri_ds3231` / `dri_lsm6dsm` / `dri_ssd1315`），蓝牙的 Modbus 业务留在 `App/app_ble`、风扇温度策略留在 `App/app_fan`；`utils_pid` 归 `Utils`；`int_key` 实现按键事件扫描。依赖方向 `App/Menu → Dri → Int → HAL`。编译 Code=73232 RO=3312 RW=848 ZI=20864，0 Error 0 Warning |

---

*本文件由开发过程维护，如与代码不一致以代码为准（`MDK-ARM/User/**`）。*
