qq45119626FangZhi/Temperature-Controlled-Blender/TempStir/MDK-ARM/Doc/整体规划.md

# 智能温控搅拌机 固件整体规划

> 依据：`MDK-ARM/Doc/SCH_主控_2_2026-08-27new.pdf`（原理图 V1.0，A4，1 页，嘉立创 EDA）
> 目标 MCU：STM32F103RCT6（Cortex-M3，256KB Flash / 48KB RAM，HSE 8MHz→72MHz）
> 依据补充：`MDK-ARM/Doc/ECB01C-TSSOP16蓝牙芯片技术手册V1.4.pdf`（11 页）
> 软件平台：STM32Cube HAL + FreeRTOS + Keil MDK-ARM V5（ARMCC V5，标准 C 库）
> 文档状态：**决策已确认版（2026-11-03）**——第 13 节 12 项已逐条确认；FreeModbus 已引入并编译通过。

---

## 1. 产品与功能目标

智能温控搅拌机，核心功能：

1. **温度采集与闭环加热**：板载 NTC + 液体 NTC 双路测温，PWM 驱动加热组件，PID 控温，过温/断线/过流保护。
2. **搅拌电机调速**：编码器测速 + PWM 调速闭环，软启动、限幅、堵转保护。
3. **人机界面**：0.96" OLED（SSD1315，128×64）+ 4 按键，多级菜单设置目标温度/转速/时间。
4. **参数与时间**：M24C02 EEPROM 保存参数；DS3231 RTC 提供实时时间与秒中断。
5. **提示与散热**：蜂鸣器（PWM 4kHz，短鸣/长鸣/告警音）；风扇按温度阈值启停。
6. **通信**：RS485 Modbus RTU（从机）、CAN、蓝牙（UART4）三选/并存。
7. **故障与保护**：硬件故障锁存（74LVC1G74）读取与复位、故障停机与告警。

---

## 2. 硬件资源清单（原理图解析）

### 2.1 主控与基础
| 项目 | 器件/网络 | 说明 |
|---|---|---|
| MCU | STM32F103RCT6（U1.1/U1.2） | 主控 |
| 主时钟 | X2 8MHz（HSE） | PLL×9→72MHz；PD0/PD1 |
| 调试 | SWDIO/SWCLK（PA13/PA14） | SWD 下载调试 |
| 复位 | NRST + 复位按键/阻容 | 复位电路 |
| 启动 | BOOT0 | 启动模式选择 |

### 2.2 采集
| 项目 | 网络 | 引脚 | 说明 |
|---|---|---|---|
| 板载温度 | BOARD_ADC | PB0/ADC | NTC 分压（R14/R15 10k、R16/R17 1k） |
| 液体温度 | LIQUID_ADC | PB1/ADC | NTC 分压 |
| 加热电流 | HEAT_I_ADC | PA4/ADC | INA199（U17）放大，R29 5mΩ 采样 |
| 24V 电压 | 24V_ADC / SUPPLY_24V_ADC | PC0/ADC | 电源电压检测 |
| 六轴 | LSM6DSMTR（U22） | SPI2：PB13/14/15；CS=PB12；INT1=PC4；INT2=PC5 | 加速度/陀螺（可选功能） |
| 编码器 | M1_ENC_A/B | PB4/PB5（TIM3 编码器） | 电机转速/方向 |

### 2.3 执行
| 项目 | 网络 | 引脚/器件 | 说明 |
|---|---|---|---|
| 加热 PWM | PIDPWM / HEAT_PWM | PA0（TIM2_CH1）→ U20 UCC27517 → Q4 AO4184A | 24V 加热组件（CN1/CN2） |
| 搅拌电机 | MOTOR1/MOTOR2 | PB8（TIM4_CH3 PWM）/ PB9（固定低）→ U7 DRV8870 | 12V 直流有刷电机；PB9 严禁拉高（会反转/刹车） |
| 风扇 | MOTOR_ON | PA1（GPIO 输出，高有效）→ Q6 30P06 | 散热风扇 |
| 蜂鸣器 | BUZZ | PA8（TIM1_CH1 PWM）→ Q5 Si2302 | 无源蜂鸣器 4kHz，50% 占空比 |
| 指示 | LED1/LED2 | GL0603UR01 | 状态指示 |

### 2.4 人机与存储/时间
| 项目 | 器件 | 接口 | 说明 |
|---|---|---|---|
| OLED | HS96L03W2C03（U18，SSD1315） | I2C1：PB6(SCL)/PB7(SDA) | 0.96" 128×64 |
| EEPROM | M24C02-WMN6TP（U19） | I2C2：PB10/PB11 | 参数存储 |
| RTC | DS3231MZ+TRL（U8） | I2C2：PB10/PB11；INT/SQW=PC12（EXTI15_10） | 实时时钟 + 秒中断 |
| 按键 | SW2~SW6（KH-6X6X6H） | KEY1~KEY4：PC6/PC7/PC8/PC9 | 内部上拉，按下为低 |

### 2.5 通信
| 项目 | 器件 | 接口 | 说明 |
|---|---|---|---|
| 调试串口 | — | USART1：PA9(TX)/PA10(RX)，115200 | printf 重定向（日志） |
| RS485/Modbus | MAX13487EESA（U12）+ 隔离（U5 CA-IS3742HN） | UART4：PC10(TX)/PC11(RX)，9600 8N1 | 485A/485B（网络名 MCU_485_TX/RX） |
| CAN | TJA1050T（U10） | CAN：PA11(RX)/PA12(TX) | CAN-H/CAN-L |
| 蓝牙 | ECB01C（U11） | USART2：PA2(TX)/PA3(RX)，115200 | BL-RXD/BL-TXD（CFG1-3 悬空=内部上拉=115200） |

> 2026-11-04 更正：早期文档把 RS485 与蓝牙的串口写反（以 `Doc/SCH_主控_2_2026-08-27new.pdf` 为准：PA2=BL-RXD、PA3=BL-TXD、PC10=MCU_485_TX、PC11=MCU_485_RX）。固件已按此对调：蓝牙在 USART2，Modbus 在 UART4。

### 2.6 电源与保护
| 项目 | 器件 | 说明 |
|---|---|---|
| 24V→12V | XL1509-12（U4） | 为电机准备 |
| 24V→5V | LMR51610（U3） | 系统 5V |
| 5V→3.3V | AMS1117-3.3 | 主控 3.3V |
| 隔离 5V | B0505S-1W（U6） | 供 485/CAN 隔离侧 |
| 故障锁存 | 74LVC1G74（U21） | HEAT_FAULT_N 输入、FAULT_RST_N 复位 |
| 保护 | SMBJ 系列 TVS、SS14/SS34、保险 | 电源/通信防护 |

---

## 3. 软件分层与目录规范

严格保持以下分层（**必须**）：

| 目录 | 职责 | 改动约束 |
|---|---|---|
| `Core/Inc`、`Core/Src` | CubeMX 生成：时钟、外设初始化、中断入口 | **只改 USER CODE 区域** |
| `MDK-ARM/User/App` | 业务应用层：控制任务、状态机、保护、Modbus 业务、风扇温度策略 | 可自由改 |
| `MDK-ARM/User/Menu` | OLED、按键事件消费、用户界面（menu_ui） | 可自由改 |
| `MDK-ARM/User/Dri` | **器件驱动层（2026-11-06 新增）**：`dri_ble`（蓝牙模块 AT/收发/分帧）、`dri_buzzer`、`dri_fan`（仅引脚）、`dri_m24c02`、`dri_ds3231`、`dri_lsm6dsm`、`dri_ssd1315` | 可自由改；只做器件/模块，**不放业务策略** |
| `MDK-ARM/User/Int` | BSP：GPIO/I2C/SPI/ADC/TIM 板级封装 + `int_key` 按键事件扫描 | 可自由改 |
| `MDK-ARM/User/Utils` | 纯软件工具（无硬件依赖）：`utils_pid` | 可自由改 |
| `MDK-ARM/freertos` | FreeRTOS 内核（`FreeRTOSConfig.h` 可调） | 尽量只改配置 |
| `MDK-ARM/free_modbus` | FreeModbus 协议栈 | **不改第三方核心**（**决策 2：已引入并完成编译**，见 3.1） |

### 现状（2026-11-06 重构后）
- 已存在：
  - `User/App`（11 组）：`app_main`、`app_motor`、`app_heat`、`app_temp`、`app_fault`、`app_store`、`app_rtc`、`app_comm`、`app_modbus`、`app_imu`、`app_tune`、`app_ble`（Modbus 业务）、`app_fan`（温度策略）
  - `User/Dri`（7 组，**2026-11-06 新增**）：`dri_ble`、`dri_buzzer`、`dri_fan`、`dri_m24c02`、`dri_ds3231`、`dri_lsm6dsm`、`dri_ssd1315`
  - `User/Int`（8 组）：`int_adc`、`int_bsp_i2c1/2`、`int_bsp_pins.h`、`int_gpio`、`int_key`、`int_spi`、`int_tim`
  - `User/Utils`（1 组）：`utils_pid`
  - `User/Menu`（1 组）：`menu_ui`
- 依赖方向固定：`App/Menu → Dri → Int → HAL`；`Utils` 不依赖硬件。
- 已引入：`MDK-ARM/free_modbus`（25 个文件：核心 modbus/ + 参考移植 port/）。
- **命名规范化已完成（2026-11-05）**：`User/Inc` → `User/Int`（决策 1 已执行）；`Int` 与 `Utils` 下所有文件按"目录名前缀 + **文件名全部小写**"重命名：`int_adc.c/.h`、`int_bsp_i2c1.c/.h`、`int_bsp_i2c2.c/.h`、`int_bsp_pins.h`、`int_gpio.c/.h`、`int_spi.c/.h`、`int_tim.c/.h`、`utils_drv_m24c02.c/.h`、`utils_drv_ds3231.c/.h`、`utils_ssd1315.c/.h`；所有 `#include` 与 Keil 工程 `FilePath` 已同步为小写。
- **驱动层拆分（2026-11-06，用户确认 Q1~Q6）**：新建 `User/Dri`，`Utils` 下 4 个芯片驱动改为 `dri_m24c02/dri_ds3231/dri_lsm6dsm/dri_ssd1315`；`app_buzzer`→`dri_buzzer`、`app_ble`→`dri_ble`（只留 AT/收发/分帧）、`app_fan`→`dri_fan`（只留引脚，温度策略留在 `App/app_fan`）；`app_pid`→`Utils/utils_pid`；**函数名一律不改**（`Buzzer_* / Ble_* / Fan_* / DS3231_* / Lsm6dsm_* / M24C02_* / SSD1315_* / App_Pid*`）。Keil 新建 `Dri` 分组，IncludePath 增加 `../MDK-ARM/User/Dri`。编译 Code=73232 RO=3312 RW=848 ZI=20864，0 Error 0 Warning。
- 已实现基础框架：FreeRTOS 调度、全局状态 `App_State_t` + 互斥锁、UID 设备 ID、printf(USART1)、蜂鸣器 PWM/软件定时器、风扇 GPIO。
- 当前运行任务：仅 `CTRL`（PRIO_5，200ms 闭环）与 `UI`（PRIO_3，40ms 按键+显示）；P0~P2 的测试/演示任务（STATE_A/B、FAN_DEMO、BSP_TEST、ACT_TEST、BUZZ、Printf）已全部删除。

### 3.1 FreeModbus 引入记录（决策 2，已落地）
| 项 | 内容 |
|---|---|
| 来源 | `02_资料/free_modbus/`（FreeModbus，RTU 使能 / ASCII、TCP 关闭；`mbconfig.h` 已确认） |
| 目标 | `MDK-ARM/free_modbus/`：核心 `modbus/`（mb.c、functions/、rtu/、include/）+ 参考移植 `port/`（portserial/porttimer/portevent） |
| Keil 分组 | 新建 `free_modbus` 分组，加入 14 个 `.c` + 11 个 `.h`（第三方核心**未改**） |
| IncludePath | 增补 `../MDK-ARM/free_modbus/modbus/include`、`.../rtu`、`.../port` |
| 应用层 | 新增 `app_modbus.c/.h`（App 拆分模块之一）：实现 FreeModbus 要求的 `eMBRegHoldingCB`，保持寄存器区 8×16bit + 映射常量，与规划 9.1 寄存器表一致 |
| 编译 | `0 Error(s), 0 Warning(s)`，`Code=25848`；宏 `NDEBUG` 消除 `mbutils.c` 的 `assert()` → `__aeabi_assert` 未定义 |
| 运行状态 | **仅引入/链接，未激活**：未调用 `eMBInit()`、未创建 Modbus 任务（决策 10：通信暂不动） |

> ⚠️ **串口绑定冲突（待通信激活时校正）**：参考移植 `portserial.c` 绑定的是 `huart4`（UART4，原理图上是蓝牙 ECB01C 的 PC10/PC11）；而原理图 RS485/Modbus 走 **USART2（PA2/PA3）**。后续启用 Modbus 时需把 port 层串口由 UART4 改为 USART2，并挂接 `HAL_UART_RxCpltCallback`（`app_freemodbus_port.h` 已预留转发接口）。当前未启用，无冲突。

---

## 4. 模块划分（按层）

### 4.1 App（业务/控制）
| 模块 | 文件（建议） | 职责 |
|---|---|---|
| 入口/调度 | `app_main.c/.h`（已有） | 初始化、任务创建、全局状态、互斥锁、调度器 |
| 温度采集 | `app_temp.c/.h` | NTC ADC→温度、滤波、断线检测 |
| 加热控制 | `app_heat.c/.h` | PID 控温、PWM 限幅、过温/过流/故障处理 |
| 搅拌电机 | `app_motor.c/.h` | 编码器测速、PID 调速、软启动、堵转保护 |
| 风扇 | `App/app_fan.c/.h`（温度策略）+ `Dri/dri_fan.c/.h`（引脚） | 阈值启停（滞回） |
| 蜂鸣器 | `Dri/dri_buzzer.c/.h` | 短鸣/长鸣/告警音 |
| 故障管理 | `app_fault.c/.h` | HEAT_FAULT_N 读取、FAULT_RST_N 复位、故障状态机 |
| 参数存储 | `app_store.c/.h`（**已落地**） | M24C02 双槽 + CRC + v1→v2 迁移、运行时镜像、静置 2s 防抖落盘 |
| 时间 | `app_rtc.c/.h` | DS3231 读写、秒中断、运行计时 |
| 通信 | `app_modbus.c/.h`（**已落地**：保持寄存器回调+映射）、`app_ble.c/.h`（Modbus 业务）+ `Dri/dri_ble.c/.h`（模块驱动）、`app_can.c` | 协议从机/命令解析 |
| 指示 | `app_led.c/.h` | LED 状态指示 |

> 决策 3 确认 **App 层按模块拆分**（app_temp / app_heat / app_motor / app_fan / app_buzzer / app_fault / app_store / app_rtc / app_modbus / app_led 多文件）。已落地：app_temp、app_heat、app_motor、app_pid、app_fan、app_buzzer、app_modbus、**app_store / app_rtc（P5）**；待落地：app_fault（P7）、app_led。

### 4.2 Menu（人机）—— P4 已落地
| 模块 | 文件 | 职责 |
|---|---|---|
| 按键 + 界面 | **`menu_ui.c/.h`（已实现）** | 按键轮询扫描、软件消抖（连续 3 次采样）、长按连发（600ms 后每 80ms 一步）；菜单焦点/参数编辑；OLED 6 行渲染；**KEY1 长按进入 RTC 校时页**（独立页面，只改时分秒） |
| 页面 | 暂未拆分 | 当前为单页菜单（Speed/Plate/Liquid/Time/Motor）；后续如需多页再按 `menu_page_*.c/.h` 拆分 |

> 说明：P4 阶段将原规划的 `menu_key` / `menu` 合并为 `menu_ui`，避免单页场景过度拆分；`Menu_UiTask` 是唯一操作 SSD1315 的任务（驱动帧缓冲无锁）。

### 4.3 Int（BSP）
| 模块 | 文件 | 职责 |
|---|---|---|
| 引脚表 | `Int_bsp_pins.h`（已有） | 网络名↔引脚↔有效电平 |
| I2C | `bsp_i2c1.c/.h`、`bsp_i2c2.c/.h`（已有） | 总线读写封装 |
| GPIO | `bsp_gpio.c/.h` | 按键/LED/使能/故障脚 |
| SPI | `bsp_spi.c/.h` | LSM6DSM 片选/收发 |
| ADC | `bsp_adc.c/.h` | 多通道采样/校准 |
| TIM | `bsp_tim.c/.h` | PWM/编码器封装 |

### 4.4 Utils（器件/算法）
| 模块 | 文件 | 职责 |
|---|---|---|
| OLED | `ssd1315.c/.h`（已有） | 显示驱动 |
| EEPROM | `drv_m24c02.c/.h`（已有） | 存储驱动 |
| RTC | `drv_ds3231.c/.h`（已有） | 时钟驱动（7 字节连续读写、BCD 转换、12/24 小时制兼容） |
| IMU | `drv_lsm6dsm.c/.h`（待建） | 六轴驱动 |
| 算法 | `utils_pid.c/.h`、`utils_filter.c/.h`、`utils_crc.c/.h`、`utils_ringbuf.c/.h` | PID/滤波/CRC/环形缓冲 |

### 4.5 free_modbus
- 引入 FreeModbus（RTU），保留 `modbus/` 核心不动；仅新增 `port/` 适配（串口收发的 FreeRTOS 适配、临界区、定时器）。
- 从机地址、波特率、寄存器映射见第 9 节。

---

## 5. FreeRTOS 任务与同步设计

> 优先级用枚举 `APP_TASK_PRIO_1..5`；栈用 `APP_TASK_STACK_*`（128 字基础，默认 2 倍=256 字）。`configMAX_PRIORITIES=7`。

| 任务 | 职责 | 优先级 | 栈 | 周期/触发 | 同步 |
|---|---|---|---|---|---|
| 温度采集 | ADC→温度→滤波 | 4 | 2x | 100ms | 写全局状态（锁/队列） |
| 加热控制 | PID→PWM | 5 | 2x | 100ms | 读状态、写 PWM |
| 电机控制 | 编码器测速→PID→PWM | 5 | 2x | 20~50ms | 读编码器、写 PWM |
| 故障监控 | 读 HEAT_FAULT_N、过温/过流 | 5 | 2x | 50ms | 触发保护/告警 |
| UI/按键 | 扫描按键、刷新 OLED | 3 | 4x | 20/50ms | 队列：按键事件 |
| 通信 | Modbus/CAN/蓝牙收发 | 3 | 4x | 事件驱动 | 队列/任务通知 |
| 存储 | 参数保存（低频） | 2 | 2x | 事件/定时 | 队列 |
| 蜂鸣器/提示 | 短鸣/长鸣/告警音 | 2 | 2x | 事件 | 软件定时器 |
| 风扇 | 阈值启停 | 3 | 1x | 500ms | 读温度 |
| Timer Service | FreeRTOS 软件定时器 | 2 | 2x（configMINIMAL*2） | 内核 | — |
| IDLE | 空闲 | 0 | — | — | 可挂低功耗/看门狗喂狗 |

**同步机制**
- 互斥锁 `app_main_state_mutex`：保护 `App_State_t`（已有）。
- 队列：按键事件、UI 事件、通信帧、存储请求。
- 任务通知：DS_INT（RTC 秒中断）等轻量事件。
- 软件定时器：蜂鸣器短鸣、UI 刷新、超时。
- 事件组/信号量：按需（如"参数已变更"）。

**中断约束**
- ISR 只做：置标志、发队列、任务通知、清中断；禁止 printf、阻塞 HAL、解析。
- 调用 `...FromISR()` 的中断，其抢占优先级数值必须 ≥5（`configLIBRARY_MAX_SYSCALL_INTERRUPT_PRIORITY=5`）。
- DS_INT（EXTI15_10）已定为 6；LSM_INT1/INT2（EXTI4/EXTI9_5）若用 FromISR 需确认优先级 ≥5。

---

## 6. 中断与优先级
| 中断 | 来源 | 建议优先级（数值） | 处理 |
|---|---|---|---|
| EXTI15_10 | DS_INT（PC12） | 6（已定） | 通知 RTC 任务 |
| EXTI4 / EXTI9_5 | LSM_INT1(PC4)/INT2(PC5) | 待定（≥5 才可用 FromISR） | 通知/置位 |
| TIM3 | 编码器 | — | 计数（无需中断） |
| USART2/UART4/CAN | 通信 | ≥5 | 收字节入队/中断处理 |
| SysTick | RTOS 节拍 1kHz | 最低 | 内核 |
| TIM6 | HAL 时基 | — | HAL |

---

## 7. 关键机制与控制策略

### 7.1 温度与加热
- NTC 采集：ADC→电压→查表/Steinhart-Hart→温度；滑动平均/中值滤波；断线/短路判定。
- 控温：目标温度 vs 当前温度 → PID → 加热 PWM（TIM2_CH1，PA0，**20kHz**）；带积分限幅、输出限幅、抗饱和。
- 加热 PWM 频率：CubeMX 原为 PSC=71/ARR=999 → **1kHz**，正好在人耳最敏感频段，24V 加热组件/线束在开关时发出明显“低鸣”（实测定位：按下加热通道即出现、关闭即消失）。现改为 PSC=0/ARR=3599 → **20kHz**（与电机 PWM 同频，超出听觉范围）；`.ioc` 已同步，`Int_TimInit()` 中另做一次强制校正，防止重新生成代码后回退。
- 保护：过温、升温异常、传感器故障 → 立即关加热、进入 FAULT、蜂鸣器告警。
- 电流：HEAT_I_ADC 监测加热电流（INA199），过流保护。

### 7.2 搅拌电机
- 测速：TIM3 编码器（PB4/PB5），定时计算 RPM。
- 调速：PID → TIM4_CH3 PWM（PB8，20kHz）；PB9 固定低（否则反转/刹车）。
- 保护：堵转（转速长期为 0 且占空比高）、过流、软启动（占空比斜坡）。

### 7.3 风扇
- 按温度滞回启停：**已实现 ≥35.0℃ 开、≤32.0℃ 关（回差 3℃），并强制两次切换间隔 ≥5s**；MOTOR_ON 高有效。
- 修改背景：原实现为单一门限 30.0℃（只有 5s 时间回差、无温度回差），板子自热即可越过门限，导致温度在 30℃ 附近长期"开-关-开"循环。阈值随 NTC 标定完成后可再复核。

### 7.4 故障与锁存
- HEAT_FAULT_N（PC3，低有效）由 74LVC1G74 锁存；故障时关加热/电机、UI 告警、蜂鸣器。
- FAULT_RST_N（PC2，开漏）复位锁存；故障排除后手动/自动复位。

### 7.5 状态机（建议）
`IDLE → HEATING → STIRRING/RUNNING → DONE`，任一环节故障 → `FAULT`。
- 由 `App_SysState_t`（IDLE/RUNNING/FAULT）承载，扩展内部子状态。

---

## 8. UI 规划（Menu）
- 页面：主界面（当前/目标温度、转速、剩余时间、状态）、设置页（温度/转速/时间）、告警页、关于页（设备 ID）。
- 按键：KEY1~KEY4 分配（如：上/下/确认/返回，或焦点切换/加减）；支持短按、长按、连按。
- 刷新：20~50ms 扫描；OLED 局部刷新，避免闪烁。
- 设备 ID 显示：`app_main_state.device_id`（UID 计算，已实现）。

---

## 9. 通信规划
### 9.1 Modbus RTU（主推，USART2/RS485）
- **决策 2 确认**：RS485 从机，**波特率 9600 8N1**（无校验、8 数据位、1 停止位）；从机地址建议 `1`（范围 1~247，具体值待定），后续存入 EEPROM。
- 协议栈：FreeModbus RTU（已引入，见 3.1）；**当前仅引入未激活**（决策 10）。启用时先把 port 层串口从 `huart4` 校正到 `huart2`。
- 寄存器映射（建议）：
  | 地址 | 内容 | 读写 |
  |---|---|---|
  | 0x0000 | 当前温度 | R |
  | 0x0001 | 目标温度 | R/W |
  | 0x0002 | 当前转速 | R |
  | 0x0003 | 目标转速 | R/W |
  | 0x0004 | 剩余时间 | R |
  | 0x0005 | 系统状态 | R |
  | 0x0006 | 故障码 | R |
  | 0x0007 | 控制命令（启动/停止/复位） | R/W |
- FreeModbus 移植：串口收（USART2 中断/空闲中断）→ 队列 → 协议栈；发送走 HAL。

### 9.2 CAN（可选）
- TJA1050，PA11/PA12；波特率待定；报文协议待定。

### 9.3 蓝牙 ECB01C（UART4，PC10/PC11）
> 依据 `Doc/ECB01C-TSSOP16蓝牙芯片技术手册V1.4.pdf`（决策 12 已确认参考）。**蓝牙转串口透传芯片**，非可编程 BLE 协议栈，MCU 只需 UART + 可选 GPIO。

**串口参数（硬件决定，非软件可改）**
- 固定 **8 数据位 / 无校验 / 1 停止位**；波特率由 **CFG1/CFG2/CFG3 引脚电平**决定（内部上拉，悬空=1）：

  | CFG1,2,3 | 波特率 | CFG1,2,3 | 波特率 |
  |---|---|---|---|
  | 111 | 115200 | 011 | 9600 |
  | 110 | 57600 | 010 | 14400 |
  | 101 | 38400 | 001 | 4800 |
  | 100 | 19200 | 000 | 2400 |

- 规划沿用工程现状 **115200 8N1**（对应 CFG=111，需核对板上电阻/原理图）；供电 1.8~3.6V（推荐 3.3V），XTAL 为 16MHz 10ppm 9pF 无源晶振（内部已有负载电容，**不要外接电容**）。

**AT 命令（配置/查询）**
- 格式：以 `AT` 开头、以 `\r\n`（`0x0D 0x0A`）结尾；芯片**先回显收到的内容，再返回结果**；非 AT 数据直接蓝牙透传。
- 常用：`AT`→`OK`（测试）、`AT+VER?`、`AT+MODEL?`（`ECB01C-TSSOP16`）、`AT+RST`、`AT+LINK?`（`OnLine`/`OffLine`）、`AT+NOTIFY?`（0/1 订阅状态）、`AT+MTU?`、`AT+DISC`、`AT+NAME?`/`AT+NAME=X`（最多改 10 次）、`AT+MAC?`/`AT+MAC=X`（最多改 3 次）。
- 名称/ MAC 修改次数有限，**仅适合出厂配置，禁止运行时反复写**。

**透传行为与约束**
- 只有手机端**开启 Notify 订阅**（`+NOTIFY:1`）后，串口数据才透传给手机；芯片**不能主动开启订阅**。
- 连接成功 TXD 主动输出 `CONNECT OK\r\n`，断开输出 `DISCONNECT\r\n`（MCU 可解析作连接状态，比 STA 引脚更直接）。
- 每包最大：未设 MTU 时 **20 字节**、设 MTU 后 **244 字节**（MTU-3，MTU 可为 23/247，由手机端改）；**两次发送间隔 ≥100ms**（低波特率需更大）。
- 手机端 3 分钟无数据，芯片主动断开连接；`STA` 引脚（未连接低/高阻、已连接高）需 MCU 配**下拉输入**，可选使用。
- UUID：服务 `FFF0` / Notify `FFF1` / 写特征 `FFF2`；默认名称 `BT_XXXX...`。

**待办**：P6 阶段实现 `app_ble.c`（UART4 中断接收 + AT/透传分流 + 连接字串解析），具体命令协议（业务帧格式）决策 10 暂不展开。

---

## 10. 存储与时间
- M24C02（I2C2）：保存目标温度、PID 参数、校准系数、波特率/从机地址、运行统计；带版本号 + CRC，双备份。
  - **v2 布局**（结构体 92 字节，编译期校验 ≤ 96）：槽 0 = `0x40~0x9F`、槽 1 = `0xA0~0xFF`；每次写“非当前有效”槽并 `seq+1`，上电取 seq 较大的有效槽。
  - **字段**：magic/version/seq；UI 参数（speed/plateTemp/liquidTemp/runTimeSec）；PID 增益 ×1000 定点（motorPidKp/Ki/Kd、heatPidKp/Ki/Kd）；校准系数（encoderPpr、gearRatioX100、liquidOffsetC10、boardOffsetC10）；通信（modbusBaud、slaveAddr）；统计（totalRunSec、heatRunSec、motorStartCnt、bootCnt）；crc。
  - **v1→v2 迁移**：v2 两槽均无效时读取旧槽 `0x00/0x20`（28 字节，仅 UI 参数），保留 4 个 UI 值、其余填默认值，并立即回写 v2 到 `0xA0`（与旧槽不重叠，失败下次上电再迁移）。
  - **写入策略**：参数改动只置 pending，静置 `APP_STORE_SAVE_DELAY_MS`(2s) 后由 `App_StoreFlushSave()` 统一写一次；运行统计每 5 分钟批量落盘，电机停机时也触发一次。
  - **运行时镜像**：`App_StoreGet()` 取只读镜像，各模块用 `App_StoreSetUi/SetMotorPid/SetHeatPid/SetCalib/AddMotorStart/StatsTick` 更新，落盘时整体写入。
- DS3231（I2C2）：读写时间、秒中断（DS_INT/PC12）用于计时与 UI 刷新；掉电走时。驱动 `drv_ds3231`，App 封装 `app_rtc`。
  - **时间有效性**：读状态寄存器 0x0F 的 OSF（bit7）；`DS3231_SetTime()` 写完自动清 OSF。`App_RtcInit()` 发现 OSF=1（首次上电/换电池）时，用 `__DATE__/__TIME__` 的**编译时刻**兜底写入一次，保证上电即有可用走时基准。
  - **1Hz 秒节拍**：`DS3231_Enable1HzSqw()` 写控制寄存器 0x0E=0x00（INTCN=0、RS=00）→ INT/SQW 输出 1Hz；EXTI15_10(DS_INT) 中断调 `App_Main_NotifyFromISR()`，UI 任务用 `App_Main_AttachNotifyTask()` 挂接接收（仅置脏标记触发重绘）。**SQW 未接/未使能时系统仍按 40ms 轮询刷新，功能不受影响**；倒计时仍以 tick 为准（防止 SQW 丢失导致不能自动停机）。
  - **校时入口（主）**：面板 **长按 KEY1（≥600ms）** 进入校时页——KEY1 循环切 年/月/日/时/分/秒、KEY2/KEY3 增减（年 2000~2099、月 1~12、日按当月天数、24/60 循环）、KEY4 写入 RTC 并退出；星期由 `App_Rtc_Weekday()`（Sakamoto）自动推算。**日期必须可改**：只改时分秒会让日期永久停在固件编译日。不依赖串口 RX（**实测本机 USB 转串口只有 MCU→PC 方向**）。
  - **掉电诊断**：`App_RtcWasAutoInit()` 反映本次上电是否因 OSF=1 用编译时刻兜底初始化；启动日志会额外打印 `[P5] RTC time lost (OSF=1) -> init from build time, check battery`，用于判定纽扣电池是否失效。
  - **校时入口（备）**：串口 USART1 轮询命令（UI 任务内解析，不占用中断）：`time YYYY-MM-DD HH:MM:SS` 设置时间，单独 `time` 回读；RX 接线可用时方生效。编程入口为 `App_RtcSetTime()`。
  - **秒节拍自检**：1Hz 方波使能后若 5s 内无 DS_INT 中断，串口打印一次 `[P5] DS_INT no edge in 5s (sqw on), polling fallback`，刷新退化为 40ms 轮询（功能不受影响）。
  - 启动打印 `[P5] EEPROM=/DS3231=(含 valid/sqw)/PARAM=/CALIB=/STAT=` 便于验收。

---

## 11. 开发阶段（里程碑）

| 阶段 | 内容 | 验收 |
|---|---|---|
| P0 基础框架（**已完成**） | FreeRTOS、状态+互斥锁、UID、printf、蜂鸣器、风扇、**FreeModbus 引入（仅链接）** | 串口日志、风扇演示、`0 Error/0 Warning` |
| P1 BSP 完善（**已完成**） | Int_gpio/Int_adc/Int_spi/Int_tim 封装、引脚表核对 | ✅ 烧录实测：SPI WHO_AM_I=0x6A、PWM CCR 正确、ADC 四路合理（B/L/I/V）、按键/故障正常 |
| P2 传感器与执行器（**已完成**） | app_temp（NTC→温度+滤波+断线）、app_heat（加热 PWM+过流/故障）、app_motor（电机 PWM+编码器 RPM） | ✅ 温度实测 22.6/22.0℃、加热升温（22.6→33.8℃）、**电机已转动**；PID 参数待 P3 实测整定 |
| P3 控制算法（**已完成，已验收**） | 温控 PID（app_heat，600ms/DT=0.6）、转速 PID（app_motor，200ms/DT=0.2）、软启动（5%/周期）、限幅（占空比上限 + PID 输出/积分上限对齐 + 抗饱和 + 输出钳零） | ✅ 已验收：控制周期与 DT 严格对齐；PID 输出/积分上限等于实际执行上限（消除 windup）；TIM3 16bit 计数器跨界安全；转速量纲统一为**电机轴 RPM**并按分钟计算；`[P3E]` 自动评估稳态误差/超调/调节时间；`0 Error 0 Warning` 并烧录验证 |
| P4 UI（**已完成，已验收**） | 4 按键（KEY1 切换焦点 / KEY2 参数+ / KEY3 参数- / KEY4 电机启停）+ SSD1315 OLED 菜单（`User/Menu/menu_ui.c`） | ✅ 已验收：6 行显示设定/实测双数值（Speed=设定/编码器实测电机轴RPM、Plate=设定/铝板实测、Liquid=设定/液体实测、Time=设定/剩余秒、Motor=Running/Idle）；支持长按连发快调；定时以秒为单位、电机启动即计时、归零自动停机；风扇按铝板温度滞回启停（验收时门限 30℃，**后续修正为 ≥35℃ 开 / ≤32℃ 关 + 切换间隔 ≥5s**）；`0 Error 0 Warning` 并烧录验证 |

| P5 存储 + RTC（**已完成，已验收 2026-11-04**） | M24C02 参数（`app_store` **v2**：双槽 0x40/0xA0 + magic/version + CRC16 + v1→v2 迁移；字段含 UI 参数、PID 增益(×1000)、校准系数(PPR/减速比/温度偏移)、通信参数、运行统计；运行时镜像 + 参数改动静置 2s 落盘 + 统计每 5 分钟/停机时批量落盘；上电恢复并下发温度设定，电机上电保持停止）、DS3231 时间（`app_rtc` + `drv_ds3231`：OSF 检测 + 编译时刻兜底初始化、1Hz SQW 经 DS_INT 通知 UI 任务、串口 `time` 校时/回读；启动打印 `[P5] EEPROM=/DS3231=valid,sqw/PARAM=/CALIB=/STAT=`）、I2C2 总线在 BUSY 卡死时自动 9 时钟恢复并重试一次 | ✅ **已验收（2026-11-04）**：掉电保存/走时正常；`[P5] PARAM/CALIB/STAT` 跨多次复位一致、boot 计数递增；DS3231 走时 + 1Hz SQW 秒节拍驱动 UI 刷新；面板长按 KEY1 进六字段校时页（年/月/日/时/分/秒，星期按公历自动推算）；OSF=1 时打印时间丢失提示；同期定位并修复加热 PWM 1kHz 低鸣（见第 16 节） |

| P6 通信（**已完成 2026-11-05**：蓝牙通道 + 安卓上位机 App + 网页版上位机均已验收；RS485 侧代码就绪、硬件缺位延后补验） | 按《Doc/通信协议.md》实现：Modbus RTU 从机（UART4/RS485，9600 8N1，32 个保持寄存器，功能码 03/06/10，`app_modbus.c` + `app_comm.c` 仲裁入口）、蓝牙 BLE 透传同一套 RTU 帧（`app_ble.c`，USART2 PA2/PA3，9600 自动识别，已握手成功；模块不支持改名，按出厂名 `BT_ECB1A6B01BA2` 连接）、`app_store` v3 增通道使能位与 v2→v3 迁移；**CAN 本期不做（D4）** | ✅ **蓝牙侧已验收（2026-11-05）**：安卓上位机 App 经 BLE GATT（FFF0/FFF1 Notify/FFF2 Write）完成参数调节、启停控制、状态与故障码显示；同期修复"启动回 04"（联锁只看电机类故障）与"铝板上限误设导致永久停热"（上限取值域 {0}∪[35,120]℃）。**P6 本期结束（2026-11-05 用户确认）**：蓝牙侧 V1~V6 全部通过（含断连重连自愈、状态字 bit8）；
RS485/Modbus 代码已实现并编译通过（UART4 + MAX13487E，03/06/10、异常码、面板仲裁、`app_store` v3），但**缺 USB-485 转换器，主站实测 V7~V9 延后**，转入后续硬件到位时补验，不阻塞 P7/P8 |
| P7 保护与可靠性（**已完成，已验收 2026-11-05**） | `app_fault.c/.h`（故障字统一聚合 + 三源心跳）、IWDG（LSI 40k/64、RLR=1000 ≈1.6s，`DBGMCU_CR` 冻结便于调试）、`WDG` 守护任务（心跳齐全才喂狗）、上电打印 `[P7] reset cause: IWDG/WWDG/SW/POR/PIN/LPWR`（读完清标志）；**P7 新增需求**：① 铝板上限默认 **40℃**（`app_store` v4 迁移，0=不限制仍合法）② 液温达到目标（如 30℃）→ **关加热 + 蜂鸣器长鸣 1s**，电机继续转，状态字 `0x0005` bit9 置位；③ **堵转检测（bit5，2026-11-05 已实现）**：`app_motor` 内 200ms 评估——有目标转速 + 占空比 ≥40% + 实测 < 目标×25%（且 <10RPM）+ 连续 3s → 立即 PWM=0 并锁存，置 `APP_MB_FLT_MOTOR_STALL`；面板 KEY4 停机或写 `0x0007` 清故障位复位；堵转时同步撤加热许可 | ✅ **IWDG 复位已实测通过（2026-11-05）**：一次性注入"CTRL 心跳停报"后日志出现 `[P7] WDG: CTRL heartbeat lost (534 ms) -> stop feeding`，随后整机被 IWDG 复位（复位原因 IWDG=1）。测试注入代码已在验证通过后删除，固件仅保留复位原因打印。其余故障注入（拉低 HEAT_FAULT_N、断 NTC、抱死电机）可按需补验 |

| P8 联调与发布（**验收中：18 项硬件自检已实测通过，仅剩 24h 老化**） | 整机联调（28 项出厂自检清单）、老化（≥24h 45℃/200rpm）、**《Doc/使用文档.md》**（接口/面板/标定页/控温规则/通信寄存器表/故障码/烧录/自检清单/老化方案/已知限制/FAQ）；**P8 新增标定功能**：长按 KEY4 进标定页，可现场标定编码器 PPR、减速比×100、NTC R25/B/上拉、加热过流阈值、液温/板温偏移（EEPROM v5，v2~v4 自动迁移，新字段补默认） | ✅ 已实测：电机启停/软启动/定时停机、加热启动与到温完成、铝板限温、30℃提示音、风扇滞回、双路 NTC 断线、HEAT_FAULT_N 注入、堵转 bit5、EEPROM 掉电保持、恢复默认、RTC 校时、IWDG 复位；✅ **EEPROM v4→v5 迁移已实测**（`[P8] NTC R25=10000 B=3950 Rup=10000…`，`boot=90` 连续递增未退回默认）；⛔ RS485 本版不支持（主站三项不做）；✅ **标定页已实机点检通过**（长按 KEY4 进入→改值→保存，`[P8] CALIB saved` 且重启后保持）；**仅剩 24h 老化与温控稳态记录**；重建 `0 Error 0 Warning`（Code=63088 RO=2412 RW=712 ZI=20624） |

---

## 12. 编码规范（延续既有约定）

1. **文件命名**：新增文件以“父目录名_”为前缀，且**文件名全部小写**（不含大写字母）——
   - `App` → `app_xxx`（全小写）
   - `Int` → `int_xxx`（如 `int_adc.c`、`int_tim.c`、`int_bsp_pins.h`）
   - `Utils` → `utils_xxx`（如 `utils_ssd1315.c`、`utils_drv_m24c02.h`）
   - `Menu` → `menu_xxx`（如 `menu_ui.c`）
   - 说明：**函数名仍按第 3 条首字母大写**（`Int_AdcReadSingle`、`Utils_...` 之类 API 名不受文件命名规则影响）；文件名一律小写，`#include` 与 Keil 工程 `FilePath` 必须与磁盘文件名完全一致。
2. **变量**：全局变量 `app_main_` 前缀、小写（如 `app_main_task_handle`）。
3. **函数**：首字母大写（如 `App_Main_Init`、`Fan_Start`）。
4. **任务优先级/栈**：必须用枚举 `App_TaskPriority_t` / `App_TaskStack_t`，禁止魔法数字。
5. **ISR**：只置位/队列/通知；`...FromISR` 仅用于抢占优先级 ≥5 的中断。
6. **FreeRTOS 对象**：在 `vTaskStartScheduler()` 之前创建。
7. **新文件**：加入 Keil 工程对应分组 + IncludePath。
8. **Core 层**：只改 USER CODE 区域。

---

## 13. 决策记录（2026-11-03 已逐条确认）

> 以下为用户对原"待确认事项"的答复，作为后续开发依据。**"暂不处理/暂不动"的项保持现状，不擅自改动。**

| # | 决策 | 落实 |
|---|---|---|
| 1 | `User/Inc` → `User/Int`：**已执行（2026-11-05）** | 目录改名 `User/Int`；Keil 分组 `Inc`→`Int`；IncludePath 改为 `../MDK-ARM/User/Int`；文件加前缀且**文件名全部小写**：`int_bsp_i2c1.c/.h`、`int_bsp_i2c2.c/.h`、`int_bsp_pins.h`（原有 `int_gpio/adc/spi/tim`）；全部 `#include` 与 Keil `FilePath` 同步 |
| 2 | FreeModbus：**现在就引入** | ✅ 已落地，见 3.1。RS485 从机、波特率 **9600 8N1**、从机地址待定（建议 1）。来源 `02_资料/free_modbus/` |
| 3 | App 层：**按模块拆分**多文件 | ✅ 方向确认（4.1 表）；已落地 app_fan / app_buzzer / **app_modbus**，其余随阶段建立 |
| 4 | `User/Utils` 命名统一：**已执行（2026-11-05）** | 按"目录名前缀 + 文件名全部小写"重命名：`utils_drv_m24c02.c/.h`、`utils_drv_ds3231.c/.h`、`utils_ssd1315.c/.h`；`#include` 与 Keil 工程同步 |
| 5 | 温度/转速/风扇阈值与 PID 参数：**无经验初值，实测整定** | P3 阶段先留可调参数（存 EEPROM），不预置凭空数值；结构预留 PID 接口 |
| 6 | NTC 参数（B 值、25℃阻值、分压电阻）：**确定** | 由原理图分压网络（R14/R15 10k、R16/R17 1k）+ NTC 规格计算，P2 落地换算（查表 / Steinhart-Hart） |
| 7 | 电机：减速比、编码器线数、额定转速、**PB9 固定低** | PB9 固定低**确认**（bsp_pins 已注明，DRV8870 严禁拉高）；减速比/线数/额定转速待器件资料，P2/P3 用于 RPM 换算 |
| 8 | 风扇有效电平：bsp_pins **高有效**，原理图 Q6 30P06（P-MOS） | **以 bsp_pins 的高有效为准**（`MOTOR_ON_ACTIVE_STATE = GPIO_PIN_SET` 已实现并验证）；P-MOS 极性差异需实测复核，如有出入再调 bsp_pins |
| 9 | 蜂鸣器：4kHz 无源（PWM 驱动） | **确认**，与现有 `app_buzzer.c`（TIM1_CH1 / PA8 / 50% 占空比 / 4kHz）一致 |
| 10 | 通信取舍（Modbus/CAN/蓝牙是否都要、优先级、协议格式）：**暂不动** | 仅引入 FreeModbus **不激活**；CAN、蓝牙协议/寄存器业务帧、优先级排序**暂不展开** |
| 11 | 看门狗：**启用 IWDG** | 见下方 13.1；喂狗位置定为「监控任务集中喂狗 + 关键任务心跳」 |
| 12 | ECB01C AT/透传协议与波特率：**参考手册** | ✅ 已解析手册并固化于 9.3（115200 8N1、AT 命令集、透传约束、UUID） |

### 13.1 IWDG 设计（决策 11，**已实现 2026-11-05**）
- **启用独立看门狗 IWDG**（LSI 约 40kHz），超时窗口建议 **1~2s**（需兼顾最慢控制任务周期）。
- **喂狗位置**：不放在各任务里各喂各的（易互相掩盖），而设一个**低优先级守护任务 `App_Main_WatchdogTask`**：
  - 各关键任务（温度、加热、电机、UI、通信、故障）周期性上报「心跳」标志位/计数；
  - 守护任务检查所有心跳都在时限内刷新 → 才调用 `HAL_IWDG_Refresh(&hiwdg)`；任一任务卡死则不喂狗，触发复位。
- **约束**：CubeMX 里启用 IWDG（`MX_IWDG_Init`，只改 USER CODE 之外的生成配置由 .ioc 管理）；调试期间可先用宏临时禁用，避免烧录/单步时反复复位。
- 与 FreeRTOS 配合：守护任务优先级设为最低（`APP_TASK_PRIO_1`），但不能被饿死；`configUSE_IDLE_HOOK` 亦可作补充喂狗点（不推荐单独用，无法检测任务卡死）。

**实际落地（2026-11-05，与上面方案的差异）**
- 工程未引入 HAL IWDG 模块（`stm32f1xx_hal_iwdg.c/h` 不在工程内，`HAL_IWDG_MODULE_ENABLED` 未开），因此 `app_fault.c` **直接写 IWDG 寄存器**：`KR=0xCCCC` 启动 → `KR=0x5555` 解锁 → `PR=3`（/64 → 625Hz）→ `RLR=1000`（≈1.6s）→ 等 `SR==0` → `KR=0xAAAA` 喂狗。这样**不必改 `Core/Src/main.c` 与 `.ioc`**。
- **启动时机**：不在 `App_Main_Init()` 里启动（OLED/EEPROM/RTC 探测 + printf 可能超过 1.6s，会立刻复位），改在 `WDG` 守护任务第一次运行时启动并先喂一次；上电另有 3s 心跳宽限窗口。
- **调试冻结**：启动前置 `DBGMCU->CR |= DBGMCU_CR_DBG_IWDG_STOP`，单步/下载时内核暂停则 IWDG 停止计数，避免烧录报 "Flash Download failed" 或单步乱跳。
- **心跳源**：`CTRL`（200ms）、`UI`（40ms）、`FAULT`（50ms）三个任务；**COMM 任务不参与**（`eMBPoll()` 阻塞在协议栈事件上，周期不可控，否则空闲也会被判卡死）。
- **任务**：`FAULT`（PRIO_4，50ms，故障聚合 + 加热类故障即时断电加热）、`WDG`（PRIO_1，100ms，心跳齐全才喂狗）。
- **临时关闭**：`app_fault.h` 里 `APP_IWDG_ENABLE` 改 0 重新编译即可（会打印 `[P7] IWDG disabled`）。

---

## 14. Keil 工程配置建议

**分组（Groups）**（当前实际状态）
```
Application/MDK-ARM
Application/User/Core
Drivers/STM32F1xx_HAL_Driver
Drivers/CMSIS
Middlewares/FreeRTOS
App          -> MDK-ARM/User/App         （业务/协议/策略）
Int          -> MDK-ARM/User/Int         （✅ 2026-11-05 由 Inc 改名）
Dri          -> MDK-ARM/User/Dri         （✅ 2026-11-06 新增：器件驱动）
Utils        -> MDK-ARM/User/Utils       （2026-11-06 起只放 utils_pid）
free_modbus  -> MDK-ARM/free_modbus     （✅ 已引入，14 .c + 11 .h）
::CMSIS
```
- `App` / `Int`（原 `Inc`）/ `Dri` / `Utils` / `Menu` 分组均已建立（`Int` 于 2026-11-05 由 `Inc` 改名，`Dri` 于 2026-11-06 新增）。

**IncludePath（当前实际生效）**
```
../Core/Inc ; ../Drivers/... ; ../MDK-ARM/freertos ; ...
../MDK-ARM/User/App
../MDK-ARM/User/Int
../MDK-ARM/User/Dri         ← 2026-11-06 新增
../MDK-ARM/User/Utils
../MDK-ARM/free_modbus/modbus/include     ← 新增
../MDK-ARM/free_modbus/modbus/rtu         ← 新增
../MDK-ARM/free_modbus/port               ← 新增
```
（`../MDK-ARM/User/Menu`、`.../Int`、`.../free_modbus`（根）待目录建立时再按需追加）

**编译宏 `<Define>`**
```
USE_HAL_DRIVER,STM32F103xE,NDEBUG
```
（`NDEBUG`：消除 `mbutils.c` 中 `assert()` 对 `__aeabi_assert` 的引用，属编译期处理，**不改第三方源码**）

**其他**
- `configUSE_TIMERS=1`（已开启，蜂鸣器软件定时器使用）。
- 调试器：CMSIS-DAP（已配置）。
- 编译：ARMCC V5，C99；目标 `0 Error / 0 Warning`（引入 FreeModbus 后实测 `Code=25848`）。

---

## 15. 本次执行结果（2026-11-03）

**已完成**
1. **FreeModbus 引入**（决策 2）：源码复制到 `MDK-ARM/free_modbus/`、Keil 新建 `free_modbus` 分组（14 `.c` + 11 `.h`）、补 3 条 IncludePath、新增应用层 `app_modbus.c/.h`（`eMBRegHoldingCB` 回调 + 8×16bit 保持寄存器映射）、编译宏加 `NDEBUG`。**编译 `0 Error(s), 0 Warning(s)`，`Code=25848`**。协议栈仅引入链接，**未激活**（未调用 `eMBInit()`、未建通信任务），符合决策 10。
2. **App 层拆分**（决策 3）：确认按模块多文件；新增 `app_modbus.c/.h` 一个模块（命名遵循 `app_` 前缀规则）。
3. **ECB01C 手册解析**（决策 12）：结论固化于 9.3（115200 8N1 / AT 命令集 / 透传约束 / UUID）。
4. **规划文档**：按 12 项答复重写第 13 节为决策记录，同步刷新 3.1、4.1、9.1、9.3、11、14 节。

**明确保持不动（按你的答复）**
- `Inc`→`Int` 重命名（决策 1）、`Utils` 命名统一（决策 4）、CAN/蓝牙/Modbus 协议激活（决策 10）、PID 初值/NTC 换算/电机参数（决策 5~7，待实测或器件资料）。
- IWDG（决策 11）：方案已定（13.1），待 P7 编码；暂未改 `.ioc`、未使能、未写喂狗任务。

**待办 / 风险提示**
- ⚠️ **port 串口绑定冲突**：参考移植用 `huart4`（蓝牙），而 RS485 在 `huart2`。启用 Modbus 前必须校正 port 层 + 挂接 UART 接收回调转发（详见 3.1）。
- 从机地址具体值、Modbus 业务寄存器帧、CAN 报文格式、蓝牙业务命令：决策 10 暂不展开。
- 后续进入 P1（BSP 封装）/ P2（传感器与执行器）时再逐模块落地代码。

> 下一步：确认后即可进入 **P1 BSP 完善**（或按需先做某一模块），或先处理上述 port 串口冲突。

---

## 16. 2026-11-04 修复记录（加热 PWM 噪声 / 风扇回差 / 铝板限温回差）

**1. 板上间歇性“低鸣”定位与修复（已验收）**
- 现象：上电初始化、电机未启动即出现间断低鸣（持续约 3~5s，间隔约 100s）；与风扇无关（Plate 设 28℃、风扇不转时仍在响）。
- 定位：先做全静默固件（停三路 PWM + 引脚拉低 + 风扇锁定 + 不跑闭环）→ 噪声消失；再做面板按键逐路使能固件（KEY1 全静默 / KEY2 蜂鸣器 / KEY3 加热 / KEY4 电机）→ **KEY3 加热一开即复现，KEY1 关闭即消失**。
- 根因：加热 PWM 为 CubeMX 默认 PSC=71/ARR=999 → **1kHz**，正好落在人耳最敏感频段，24V 加热组件与线束在开关时发声；断续是因为温控 PID + 铝板限温让加热占空比间歇开关。
- 修复：加热 PWM 改为 PSC=0/ARR=3599 → **20kHz**（`Int_tim.c` 在启动 PWM 前强制校正，`.ioc` 已同步为 20kHz）。占空比按当前 ARR 动态换算，分辨率不变（3600 级）。
- 验收：静默 2 分钟无低鸣、电机运转 2 分钟无低鸣（用户实测 2026-11-04）。
- 风险提示：开关频率提高后 AO4184A 开关损耗上升，**需在实际加热工况下复核 Q4/U20 温升**；若温升偏高可降到 15kHz 或加 RC 缓冲。

**2. 风扇启停加温度回差**
- 原：单一门限 30.0℃，只有 5s 时间回差，板温贴门限会长期“开-关-开”。
- 现：`APP_FAN_PLATE_ON_C10=350`（≥35.0℃ 开）/ `APP_FAN_PLATE_OFF_C10=320`（≤32.0℃ 关），保留 5s 时间回差（`app_fan.c/.h`）。

**3. 铝板限温加 2℃ 回差**
- 原：`s_plateLimitC10` 无温度回差，板温贴限值时加热按 600ms 控制节奏断续通断。
- 现：触到上限锁存关断，降到「上限 − 2.0℃」以下才解除（`APP_HEAT_PLATE_LIMIT_HYST_C10=20`）；初始化或修改限值时清除锁存（`app_heat.c`）。

**4. 定位用测试代码已全部移除**
- `APP_BRINGUP_MODE` 宏及其静默输出 / 逐路使能实现（`App_Main_SilenceOutputs`、`App_Main_PinMode`、`App_Main_BringupApply`、`App_Main_BringupKeys`）全部删除，固件恢复正式业务逻辑（PID 闭环 + 风扇自动控制 + UI 任务）。
