qq45119626FangZhi/Temperature-Controlled-Blender/TempStir/Core/Src/main.c

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
/* Includes ------------------------------------------------------------------*/
#include "main.h"
#include "adc.h"
#include "can.h"
#include "i2c.h"
#include "spi.h"
#include "tim.h"
#include "usart.h"
#include "gpio.h"

/* USER CODE BEGIN Includes */
/* FreeRTOS 内核头文件。注意：FreeRTOSConfig.h 位于 MDK-ARM/freertos，
   已加入 Keil 头文件搜索路径。此处的验证任务仅用于确认移植可用，
   后续业务任务请放到 MDK-ARM/User/App 中。 */
#include "FreeRTOS.h"
#include "task.h"
#include "app_main.h"   /* 业务应用层（MDK-ARM/User/App）FreeRTOS 封装 */
#include <stdio.h>          /* printf 已重定向到 USART1（见 usart.c） */
/* USER CODE END Includes */


void SystemClock_Config(void);
/* USER CODE BEGIN PFP */
/* 业务应用层入口在 MDK-ARM/User/App/app_main.c 中实现（App_Main_Init）。 */
/* USER CODE END PFP */

/**
  * @brief  The application entry point.
  * @retval int
  */
int main(void)
{

  /* MCU Configuration--------------------------------------------------------*/

  /* Reset of all peripherals, Initializes the Flash interface and the Systick. */
  HAL_Init();

  /* Configure the system clock */
  SystemClock_Config();

  /* Initialize all configured peripherals */
  MX_GPIO_Init();
  MX_ADC1_Init();
  MX_I2C1_Init();
  MX_I2C2_Init();
  MX_SPI2_Init();
  MX_TIM1_Init();
  MX_TIM2_Init();
  MX_TIM3_Init();
  MX_TIM4_Init();
  MX_UART4_Init();
  MX_USART1_UART_Init();
  MX_USART2_UART_Init();
  MX_CAN_Init();
  /* USER CODE BEGIN 2 */
  /* 程序入口： */
  App_Main_Init();

  /* USER CODE END 2 */

  /* Infinite loop */
  /* USER CODE BEGIN WHILE */
  while (1)
  {
    /* USER CODE END WHILE */

    /* USER CODE BEGIN 3 */
  }
  /* USER CODE END 3 */
}

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
/* USER CODE BEGIN 4 */

/* 验证任务与 printf 串口测试任务已迁移至 MDK-ARM/User/App/app_main.c
   （App_Main_Init → App_Main_PrintfTask），本区域保留供后续扩展。 */

/* USER CODE END 4 */

/**
  * @brief  Period elapsed callback in non blocking mode
  * @note   This function is called  when TIM6 interrupt took place, inside
  * HAL_TIM_IRQHandler(). It makes a direct call to HAL_IncTick() to increment
  * a global variable "uwTick" used as application time base.
  * @param  htim : TIM handle
  * @retval None
  */
void HAL_TIM_PeriodElapsedCallback(TIM_HandleTypeDef *htim)
{
  if (htim->Instance == TIM6)
  {
    HAL_IncTick();
  }
}

/**
  * @brief  This function is executed in case of error occurrence.
  * @retval None
  */
void Error_Handler(void)
{
  /* USER CODE BEGIN Error_Handler_Debug */
  /* User can add his own implementation to report the HAL error return state */
  __disable_irq();
  while (1)
  {
  }
  /* USER CODE END Error_Handler_Debug */
}
#ifdef USE_FULL_ASSERT
/**
  * @brief  Reports the name of the source file and the source line number
  *         where the assert_param error has occurred.
  * @param  file: pointer to the source file name
  * @param  line: assert_param error line source number
  * @retval None
  */
void assert_failed(uint8_t *file, uint32_t line)
{
  /* USER CODE BEGIN 6 */
  /* User can add his own implementation to report the file name and line number,
     ex: printf("Wrong parameters value: file %s on line %d\r\n", file, line) */
  /* USER CODE END 6 */
}
#endif /* USE_FULL_ASSERT */
