qq45119626FangZhi/Temperature-Controlled-Blender/TempStir/MDK-ARM/User/Int/int_bsp_i2c1.c

/*
* int_bsp_i2c1.c
* I2C1 的线程安全 HAL 适配层，当前服务于 OLED。
 *
 * 业务模块只能调用本文件头文件暴露的接口，不直接操作 I2C HAL 状态机。
 * 调度器启动前没有任务并发，因此启动自检期间有意跳过互斥量。
 */
#include "int_bsp_i2c1.h"
#include "i2c.h"
#include "int_bsp_pins.h"
#include "FreeRTOS.h"
#include "semphr.h"
#include "task.h"

static SemaphoreHandle_t s_i2c1Mutex = NULL;

void Bsp_I2c1Init(void)
{
    if (s_i2c1Mutex == NULL)
    {
        s_i2c1Mutex = xSemaphoreCreateMutex();
    }
}

static void Bsp_I2c1BitDelay(void)
{
    volatile uint32_t count = SystemCoreClock / 1000000U;

    while (count > 0U)
    {
        count--;
        __NOP();
    }
}

HAL_StatusTypeDef Bsp_I2c1RecoverBus(void)
{
    GPIO_InitTypeDef gpio = {0};
    HAL_StatusTypeDef lineStatus;
    uint8_t pulse;

    /* 从设备占用 SDA 时复位 MCU，F1 I2C 可能残留 BUSY；先关闭并复位外设。 */
    (void)HAL_I2C_DeInit(&hi2c1);
    __HAL_RCC_I2C1_FORCE_RESET();
    __HAL_RCC_I2C1_RELEASE_RESET();

    HAL_GPIO_WritePin(OLED_SCL_GPIO_Port, OLED_SCL_Pin, GPIO_PIN_SET);
    HAL_GPIO_WritePin(OLED_SDA_GPIO_Port, OLED_SDA_Pin, GPIO_PIN_SET);
    gpio.Pin = OLED_SCL_Pin | OLED_SDA_Pin;
    gpio.Mode = GPIO_MODE_OUTPUT_OD;
    gpio.Pull = GPIO_NOPULL;
    gpio.Speed = GPIO_SPEED_FREQ_HIGH;
    HAL_GPIO_Init(OLED_SCL_GPIO_Port, &gpio);
    Bsp_I2c1BitDelay();

    /* 输出最多 9 个 SCL 脉冲，让从设备完成被中断的一个字节并释放 SDA。 */
    for (pulse = 0U; pulse < 9U; pulse++)
    {
        if (HAL_GPIO_ReadPin(OLED_SDA_GPIO_Port, OLED_SDA_Pin) == GPIO_PIN_SET)
        {
            break;
        }
        HAL_GPIO_WritePin(OLED_SCL_GPIO_Port, OLED_SCL_Pin, GPIO_PIN_RESET);
        Bsp_I2c1BitDelay();
        HAL_GPIO_WritePin(OLED_SCL_GPIO_Port, OLED_SCL_Pin, GPIO_PIN_SET);
        Bsp_I2c1BitDelay();
    }

    /* SCL 为高期间让 SDA 从低变高，生成符合 I2C 规范的 STOP。 */
    HAL_GPIO_WritePin(OLED_SDA_GPIO_Port, OLED_SDA_Pin, GPIO_PIN_RESET);
    Bsp_I2c1BitDelay();
    HAL_GPIO_WritePin(OLED_SCL_GPIO_Port, OLED_SCL_Pin, GPIO_PIN_SET);
    Bsp_I2c1BitDelay();
    HAL_GPIO_WritePin(OLED_SDA_GPIO_Port, OLED_SDA_Pin, GPIO_PIN_SET);
    Bsp_I2c1BitDelay();

    lineStatus = ((HAL_GPIO_ReadPin(OLED_SCL_GPIO_Port, OLED_SCL_Pin) == GPIO_PIN_SET) &&(HAL_GPIO_ReadPin(OLED_SDA_GPIO_Port, OLED_SDA_Pin) == GPIO_PIN_SET)) ?HAL_OK : HAL_ERROR;

    /* MX_I2C1_Init() 将 PB6/PB7 恢复为复用开漏，并重新配置 100 kHz I2C1。 */
    MX_I2C1_Init();
    return lineStatus;
}

static void Bsp_I2c1Lock(void)
{
    /* 启动阶段尚无任务并发；调度器启动后才获取互斥量。 */
    if ((s_i2c1Mutex != NULL) && (xTaskGetSchedulerState() != taskSCHEDULER_NOT_STARTED))
    {
        (void)xSemaphoreTake(s_i2c1Mutex, portMAX_DELAY);
    }
}

static void Bsp_I2c1Unlock(void)
{
    /* 与 Bsp_I2c1Lock() 条件严格匹配，未获取时绝不释放。 */
    if ((s_i2c1Mutex != NULL) && (xTaskGetSchedulerState() != taskSCHEDULER_NOT_STARTED))
    {
        (void)xSemaphoreGive(s_i2c1Mutex);
    }
}

HAL_StatusTypeDef Bsp_I2c1MasterTransmit(uint16_t devAddress, const uint8_t *data, uint16_t size, uint32_t timeout)
{
    HAL_StatusTypeDef status;

    Bsp_I2c1Lock();
    status = HAL_I2C_Master_Transmit(&hi2c1, devAddress, (uint8_t *)data, size, timeout);
    Bsp_I2c1Unlock();

    return status;
}

HAL_StatusTypeDef Bsp_I2c1MemWrite(uint16_t devAddress, uint16_t memAddress, uint16_t memAddSize,const uint8_t *data, uint16_t size, uint32_t timeout)
{
    HAL_StatusTypeDef status;

    Bsp_I2c1Lock();
    status = HAL_I2C_Mem_Write(&hi2c1, devAddress, memAddress, memAddSize, (uint8_t *)data, size, timeout);
    Bsp_I2c1Unlock();

    return status;
}

HAL_StatusTypeDef Bsp_I2c1MemRead(uint16_t devAddress, uint16_t memAddress, uint16_t memAddSize,uint8_t *data, uint16_t size, uint32_t timeout)
{
    HAL_StatusTypeDef status;

    Bsp_I2c1Lock();
    status = HAL_I2C_Mem_Read(&hi2c1, devAddress, memAddress, memAddSize, data, size, timeout);
    Bsp_I2c1Unlock();

    return status;
}

HAL_StatusTypeDef Bsp_I2c1IsDeviceReady(uint16_t devAddress, uint32_t trials, uint32_t timeout)
{
    HAL_StatusTypeDef status;

    Bsp_I2c1Lock();
    status = HAL_I2C_IsDeviceReady(&hi2c1, devAddress, trials, timeout);
    Bsp_I2c1Unlock();

    return status;
}
